WLANThermo/WLANThermo_Hardware/mini v3/Readme.md

WLANThermo Mini V3 Hardware Files

License: Creative Commons - Attribution - Non-Commercial - Share Alike license
