WLANThermo/WLANThermo_Hardware/mini v2/Readme.md

An dieser Stelle findest du die Open-Source-Inhalte zum WLANThermo Mini v2.

Inhaltsverzeichnis:
- case: beinhaltet den Link zu den Druckdateien für das 3D-Druck-Gehäuse
- bom: beinhaltet die Komponentenliste mit Lieferanten-Links
- circuit: beinhaltet den Schaltplan der Platine und den Bestückungsaufdruck
- documentation: beinhaltet alle Aufbauhilfen und Prozessanleitungen
- gerber: beinhaltet die GERBER-Dateien der Platine
- picture: beinhaltet Bilder rund ums Mini und den Dokumentationen
- target: beinhaltet das Target-Projekt zur Platine

Weitere Informationen zum WLANThermo Mini v2 findest du auf der [WLANThermo-Homepage](https://wlanthermo.de/) oder im [WLANThermo-Forum](https://forum.wlanthermo.de/).
