WLANThermo/WLANThermo_Hardware/mini v2/gerber/Readme.md

Hinweise zur Platinenherstellung:

- Layer: 2
- PCB Thickness: 1.0 mm
- Copper Weight: 1oz 35um
- PCB Color: black
- Surface Finish: Hasl (lead free)
