WLANThermo/WLANThermo_Hardware/mini v2/case/Readme.md

Für das WLANThermo Mini v2 findest du das aktuelle 3D-Druck-Gehäuse auf thingiverse. Siehe [hier](https://www.thingiverse.com/thing:2134403). Du kannst dir ein Gehäuse entweder anhand der hier hinterlegten STL-Dateien selbst drucken oder die STL-Dateien an einen Druckdienst weitergeben und es dort fertigen lassen. Eine Anleitung, wie das geht, findest du [hier](https://github.com/WLANThermo/WLANThermo_Hardware/blob/master/mini%20v1/documentation/Geh%C3%A4usebestellung_3DHubs.pdf). Als dritte Option besteht auch noch die Möglichkeit ein Gehäuse im WLANThermo-Shop zu bestellen.

Hinweis: Die in der BOM angegebenen Schrauben gelten für die hier verlinkte Gehäusevariante. Andere Gehäusevarianten benötigen u. U. andere Schrauben.
