WLANThermo/WLANThermo_Hardware/mini v1/gerber/Readme.md

Für die Herstellung der Platine werden die hier abgelegten GERBER-Dateien benötigt. Die Platinen können z. B. hier gefertigt werden:
http://www.seeedstudio.com/service/index.php?r=pcb

Dafür die "GERBER Mini v1 Funk.zip" Datei auf der Homepage des Herstellers hochladen und folgende Fertigungseinstellungen wählen:

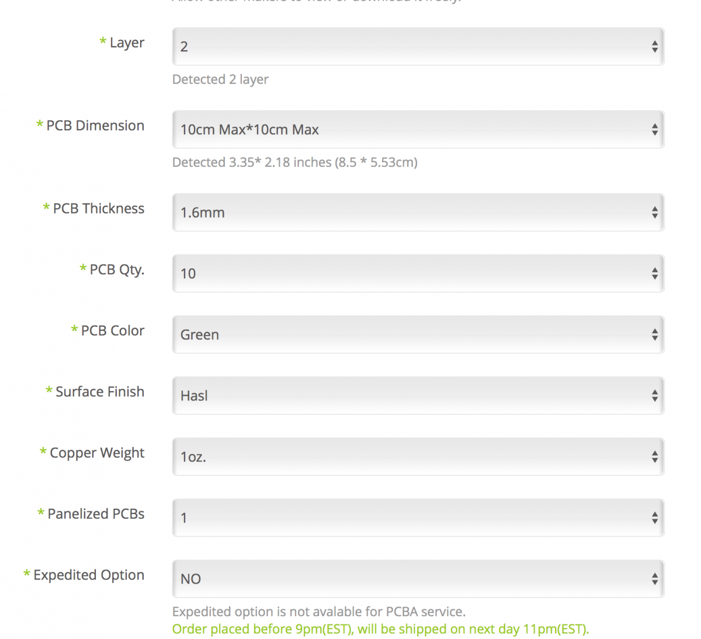
[picture p1: mini v1/picture/Platinenbestellung.png]
Platinenbestellung


Wer sich selbst keine Platine herstellen lassen will, der kann im [WLANThermo-Forum](https://forum.wlanthermo.de/) nach einer Sammelbestellung Ausschau halten oder eine Platine im [WLANThermo-Shop] bestellen.
