WLANThermo/WLANThermo_Hardware/mini v1/case/maloriak/v2/liesmich.txt

===========================================================================
             Gehäuse für das WLAN-Thermometer "Mini"
===========================================================================

// Für FDM-Drucker angepasste Version des 
// originalen Gehäuses mit runden Ecken von Sisi
//
// Kontakt: Maloriak@Grillsportverein bzw. maloriak@gmail.com
//
// Version 2.2 v. 13.2.2016
//
// Als Unterschied zur originalen Version habe ich den Deckel plan
// gemacht, damit er auf dem Drucktisch zu liegen kommmt und die 
// kleinen Gnubbel am Boden entfernt. Die Außenmasse von Deckel und Boden 
// sind daher gleich geblieben, ebenso die Innenmasse.
//
// Die Position der Anschlußlöcher im Deckel waren wohl etwas knapp,
// daher habe ich sie 0,7mm weiter Richtung Boden verschoben.
//
// Der Deckel und der Boden sind beide in dieser SCAD-Datei enthalten, sodass das einwandfreie
// Zusammenpassen der Teile anhand von Referenzpunkten sichergestellt ist.
//
// Ob der Boden oder der Deckel erzeugt wird und welche Anschlußlöcher erzeugt werden und
// ob Vorkehrungen gegen das Warpen generiert wird, lässt sich mittels Parameter einstellen.

// Dateien habe ich alle, zum Teil mehrfach, in PLA mit den Cura-Einstellungen
// 0.2 Schichtdicke, 20% Füllgrad, 0,8mm Wandstärke, 0,4mm unten/oben
// gedruckt und getestet. Mein Cura-Profil habe ich im Verzeichnis Cura-Profil abgelegt.
// Den Deckel im Slicer natürlich um 180 Grad drehen;-)

Fotos befinden sich im Unterverzeichnis Fotos und auf
http://www.grillsportverein.de/forum/threads/wlan-thermometer-mini-gehaeuse-varianten.253520/

Hinweise und Changelog siehe WTM_MaloriakV22.scad

Was bedeuten die Dateien?
==========================

a) Quelldatei, in der die originalen STL-Dateien importiert wurden und aus der die neuen 
  STL-Dateien generiert wurden:
  SCAD/WTM_MaloriakV22.scad

b) zum Selbstdrucken z.B. auf PLA-Druckern. 
Ich habe dort *immer* Schutz gegen das Warpen, also das Hochbiegen vom 
Drucktisch benötigt. Zusätzliche Eckchen halten die Ecken am Drucktisch fest.
Der von z.B. Cura automatisch generierte Schutz hat nicht so gut funktioniert,
daher habe ich ihn direkt in das Design integriert.

Boden: 
  STL_mit_Warp/WTM_Boden_V22.stl
Deckel (eine davon):
  STL_mit_Warp/Deckel_LMR_V22.stl
  STL_mit_Warp/Deckel_LR_V22.stl
  STL_mit_Warp/Deckel_M_V22.stl
  STL_mit_Warp/Deckel_V22.stl

LMR/LR/M bedeutet: Loch mitte/links/rechts

c) zum Selbstdrucken oder Drucken lassen und falls kein Warpschutz notwendig:

Boden: 
  STL/WTM_Boden_V22.stl
Deckel (eine davon):
  STL/Deckel_LMR_V22.stl
  STL/Deckel_LR_V22.stl
  STL/Deckel_M_V22.stl
  STL/Deckel_V22.stl

Falls jemand Verbesserungen/Änderungen an der Quelldatei macht, bitte 
an mich zurückmelden, damit ich sie einbauen kann.
  
Viel Erfolg beim Nachdrucken!

  LG Maloriak
===========================================================================
