WLANThermo/WLANThermo_Hardware/mini v2/documentation/QSGMini_DE.pdf

# Quick Start Guide

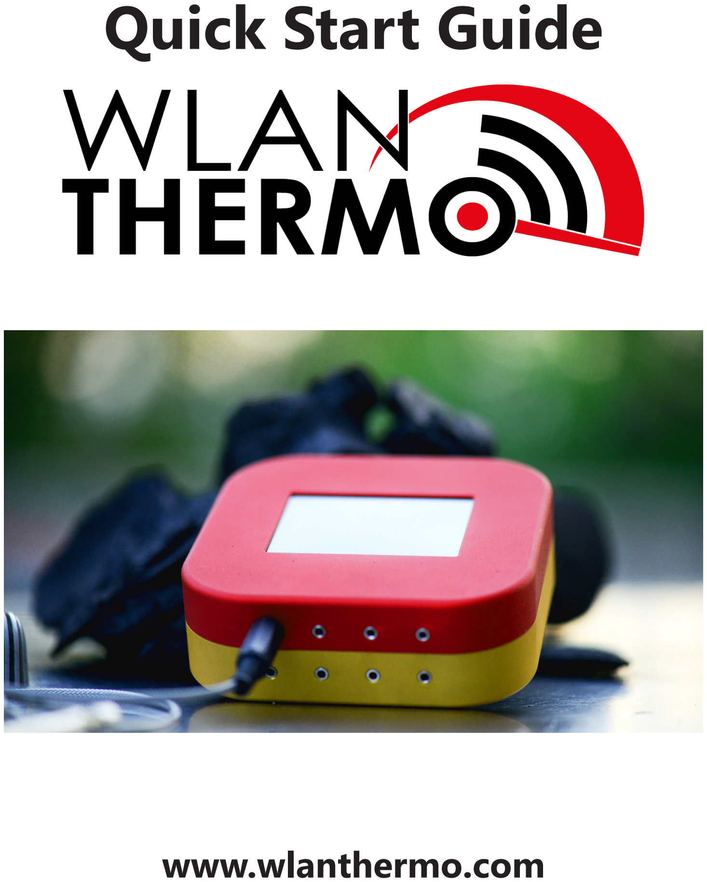
[picture p29: page 1]

## www.wlanthermo.com

2 | Inhaltsverzeichnis
3 | Hardware
3 | Vorderseite
3 | Rückseite
4 | Erste Schritte
4 | 1. Erste Inbetriebnahme
5 | 2. WLAN verbinden
6 | 3. Display Menü
7 | 4. Kanäle
9 | 5. Pitmaster
13 | GUI
16 | Credits

# Inhaltsverzeichniss:

## Hardware:

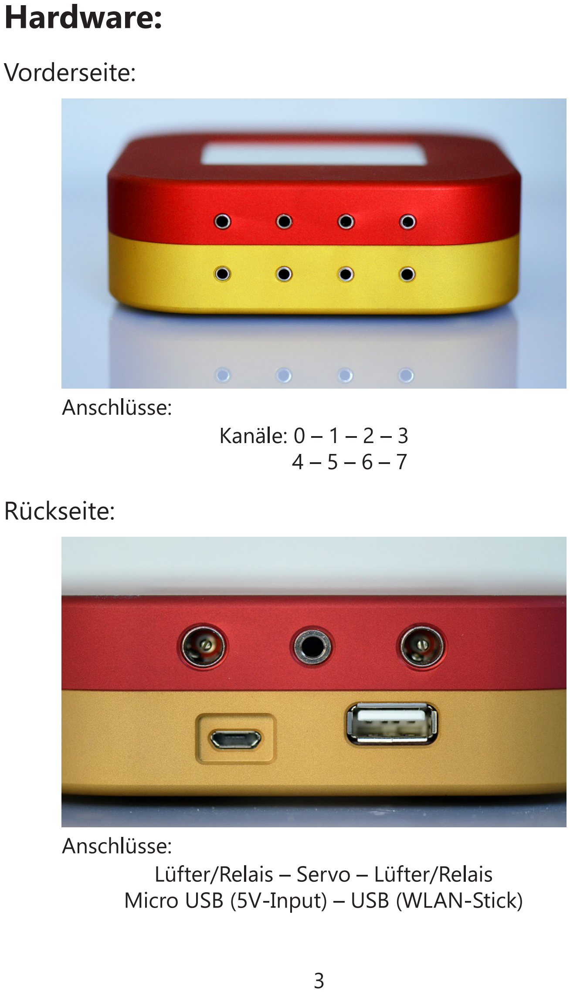
[picture p30: page 3]

Vorderseite:

Rückseite:

Kanäle: 0 – 1 – 2 – 3
4 – 5 – 6 – 7

Lüfter/Relais – Servo – Lüfter/Relais Micro USB (5V-Input) – USB (WLAN-Stick)

Anschlüsse:

Anschlüsse:

## Erste Schritte: 1. Erste Inbetriebnahme

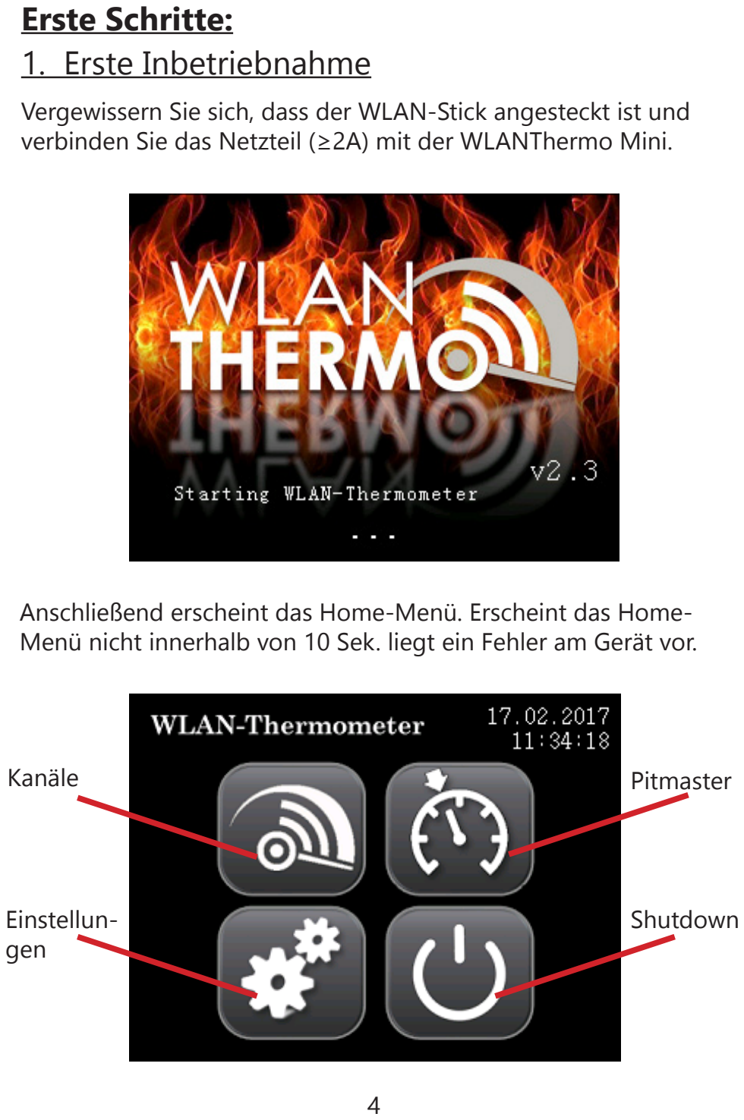
[picture p31: page 4]

Einstellungen

Kanäle | Pitmaster

Shutdown

Vergewissern Sie sich, dass der WLAN-Stick angesteckt ist und verbinden Sie das Netzteil (≥2A) mit der WLANThermo Mini.

Anschließend erscheint das Home-Menü. Erscheint das Home-Menü nicht innerhalb von 10 Sek. liegt ein Fehler am Gerät vor.

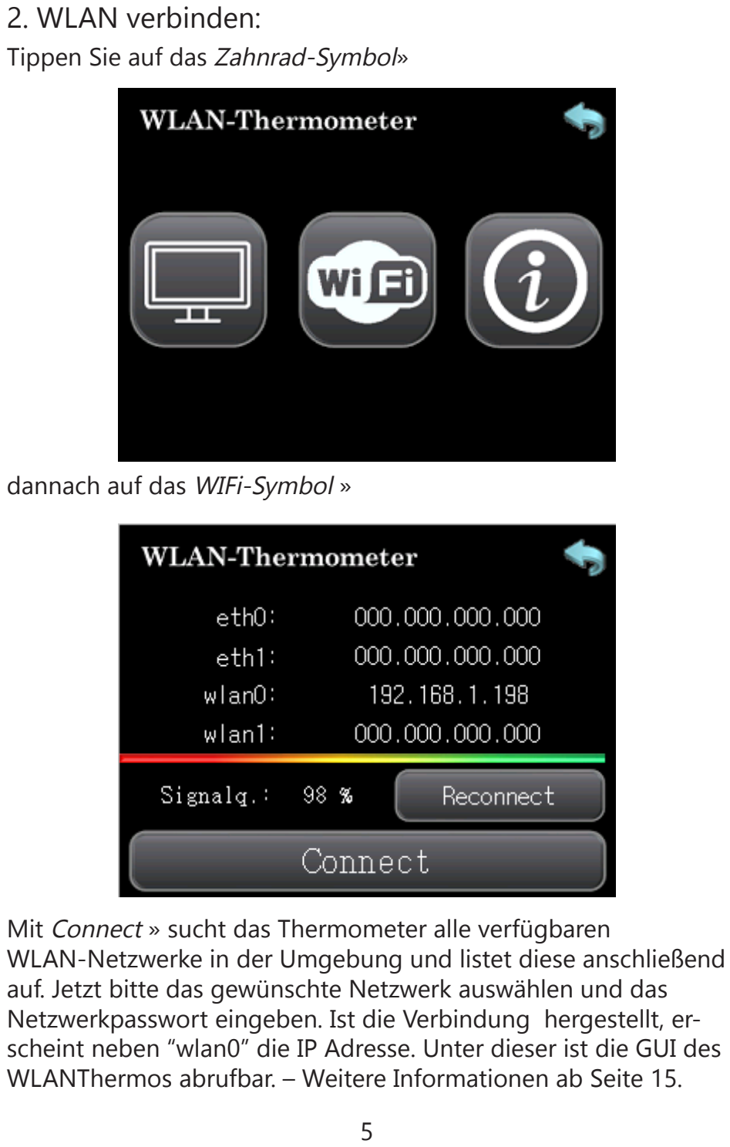
[picture p32: page 5]

dannach auf das WIFi-Symbol »

Mit Connect » sucht das Thermometer alle verfügbaren WLAN-Netzwerke in der Umgebung und listet diese anschließend auf. Jetzt bitte das gewünschte Netzwerk auswählen und das Netzwerkpasswort eingeben. Ist die Verbindung hergestellt, erscheint neben “wlan0” die IP Adresse. Unter dieser ist die GUI des WLANThermos abrufbar. – Weitere Informationen ab Seite 15.

2. WLAN verbinden:
Tippen Sie auf das Zahnrad-Symbol»

3. Display Menü:

Unter Zahnrad-Symbol» Display-Symbol » kann man die Helligkeit des Displays einstellen und festlegen, ob und wann es sich abschalten soll.

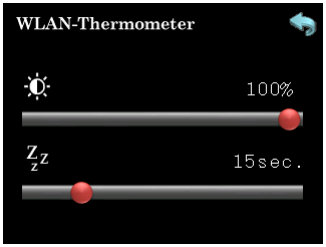
[picture p33: figure]

Es schaltet sich NUR das Display ab, das Thermometer bleibt eingeschaltet! Durch Antippen des Displays schaltet es sich jederzeit wieder ein.

Mit dem Pfeil kommt man immer zum vorherigen Menü »

4. Kanäle:
Unter dem Thermometer-Symbol » werden alle 8 Kanäle (nummeriert von 0-7) und, wenn aktiv, die Werte des Pitmaster angezeigt. Die Anzeigereihenfolge des Pitmasters ist: Ist-/Soll-Temperatur und aktuelle Aktorleistung zwischen 0 % und 100 %

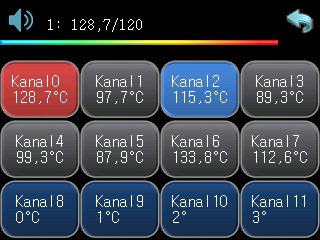
[picture p34: figure]

Wird ein Alarm ausgelöst, ertönt ein Signal – der Kanal bei dem die Temperatur überschreiten wird rot und beim unterschreiten blau eingefärbt. Links oben erscheint ein Lautsprecher-Symbol »

Ein antippen des Lautsprecher-Symbols » quittiert den Alarm, zudem wird es durchgestrichen dargestellt. Wird dannach erneut ein Alarm ausgelöst ertönt abermals ein Signalton. Sind alle Kanäle wieder im eingestellten Temperaturbereich stellt sich der Alarm von selbst wieder scharf.

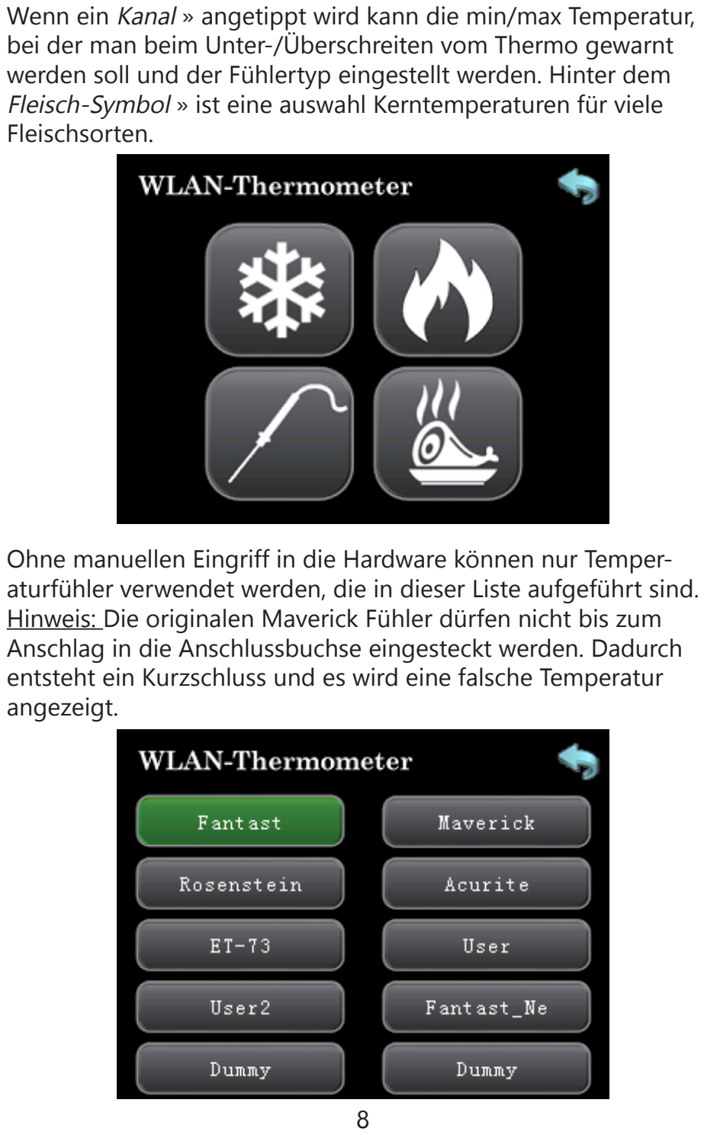
[picture p35: page 8]

Wenn ein Kanal » angetippt wird kann die min/max Temperatur, bei der man beim Unter-/Überschreiten vom Thermo gewarnt werden soll und der Fühlertyp eingestellt werden. Hinter dem Fleisch-Symbol » ist eine auswahl Kerntemperaturen für viele Fleischsorten.

Ohne manuellen Eingriff in die Hardware können nur Temperaturfühler verwendet werden, die in dieser Liste aufgeführt sind. Hinweis: Die originalen Maverick Fühler dürfen nicht bis zum Anschlag in die Anschlussbuchse eingesteckt werden. Dadurch entsteht ein Kurzschluss und es wird eine falsche Temperatur angezeigt.

Der Pitmaster kann unter dem Pitmaster-Symbol » aktiviert und eingestellt werden

5. Pitmaster:

Mit dem Pitmaster ist es möglich die Temperatur eines Grills oder Smokers mit einem Lüfter oder Servo zu steuern. Es kann auch mittels Gastronormschale, Heizmatte und SSR (SolideStateRelay) ein DIY Sous-Vide Garer gebaut weden.
Weitere Infos dazu unter: www.wlanthermo.com

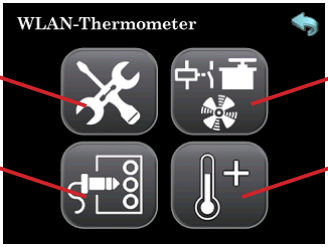
[picture p36: figure]

Kanal

Pitmaster
Steuerung

Servo/
Lüfter/Relais

Soll
Temperatur

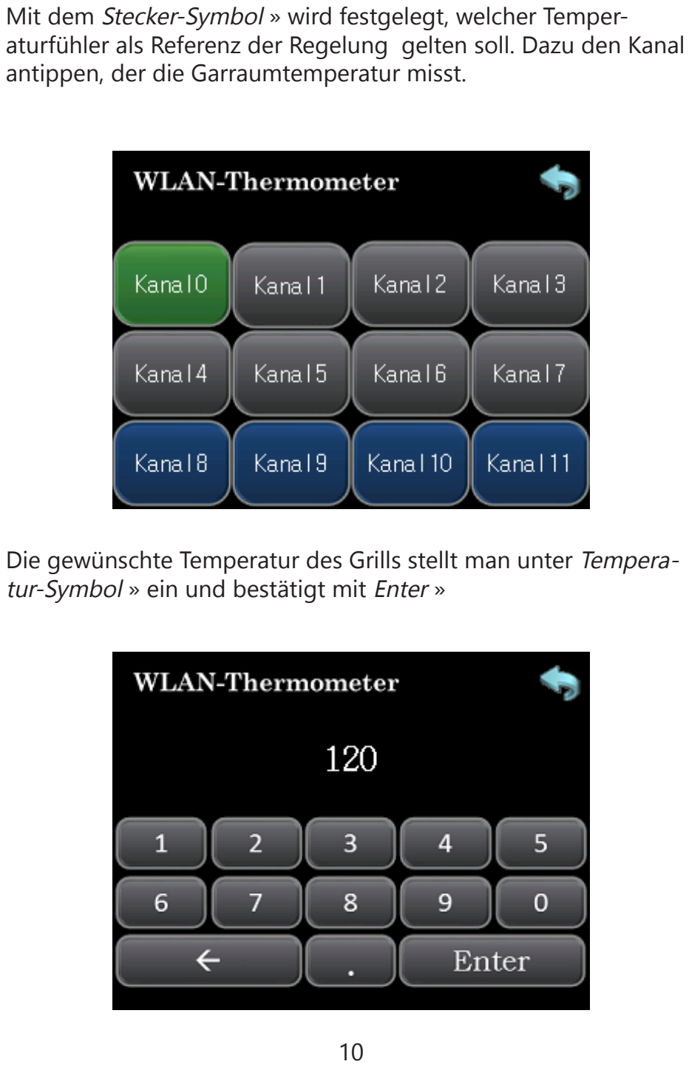
[picture p37: page 10]

Die gewünschte Temperatur des Grills stellt man unter Temperatur-Symbol » ein und bestätigt mit Enter »

Mit dem Stecker-Symbol » wird festgelegt, welcher Temperaturfühler als Referenz der Regelung gelten soll. Dazu den Kanal antippen, der die Garraumtemperatur misst.

Um das Gerät auszuwählen mit dem der Grill gesteuert werden soll auf das Symbol » mit Lüfter/Relais/Servo drücken.

Diese Geräte stehen zur Auswahl:
Servo - Lüfter - PWM Lüfter Relais - SSR (Solid State Relais)

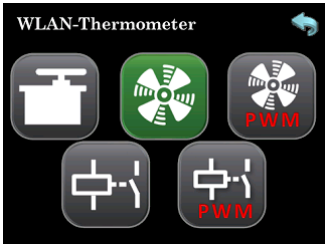
[picture p38: figure]

Mehr Information zu den verwendbaren Geräten und deren Verwendung unter: www.wlanthermo.com

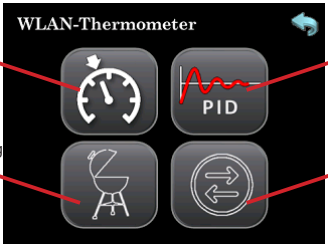
[picture p39: figure]

- Pitmaster on/off: ein/aus-schalten des Pitmasters.
- PID on/off: schaltet zwischen PID Regelung und Regelkurve um.
- Deckelüberwachung: lässt das Thermometer erkennen, dass der Deckel geöffnet ist und unterbricht den Pitmaster bis der Deckel wieder geschlossen ist.
- Ansteuerung umkehren: ändert beim Servo die Laufrichtung, beim Lüfter wird bei 0% Reglerausgangswert Vollgas gegeben, bei 100% bleibt er stehen und bei einem noramalen Relais kann damit NO oder NC (NO=Relais ist ohne angelegtem Strom Offen, NC=geschlossen) gedreht werden.

Pitmaster
on/off

Deckelüberwachung

PID on/off

Ansteuerung
umkehren

## GUI (graphical user interface):

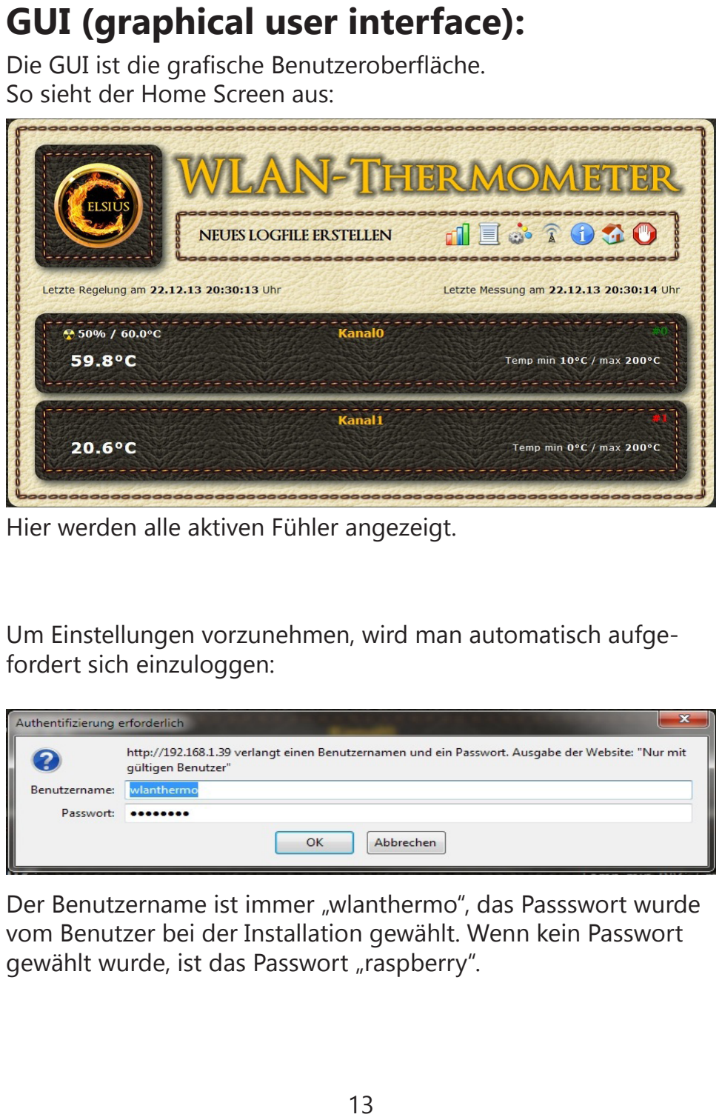
[picture p40: page 13]

Die GUI ist die grafische Benutzeroberfläche. So sieht der Home Screen aus:

Hier werden alle aktiven Fühler angezeigt.

Um Einstellungen vorzunehmen, wird man automatisch aufgefordert sich einzuloggen:

Der Benutzername ist immer „wlanthermo“, das Passswort wurde vom Benutzer bei der Installation gewählt. Wenn kein Passwort gewählt wurde, ist das Passwort „raspberry“.

Das ist die Menüleiste:

Sie enthält:

Speichert das bestehende Logfile und erstellt ein Neues und startet den Plot. Die Plot-Grafik wird nur dann auch gespeichert, wenn sie beim Erstellen eines neuen Loggfiles (siehe Unten) aktiv ist.

Aktiviert/Deaktiviert die Plot-Grafik.

Öffnet eine Seite mit den gespeicherten Logfiles, hier kann man diese auch herunterladen.

Öffnet die Einstellungen

Öffnet die WLAN Einstellungen

Öffnet eine Seite mit allgemeinen Informationen über das WLAN-Thermo. Auch Updates können hier installiert werden.

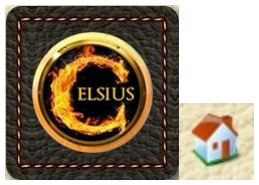
[picture p41: figure]

Mit beiden Symbolen gelangt man zurück zum Home Screen.

Hiermit ist das Herunterfahren und Neustarten möglich.
Es wird empfohlen, das WLANThermo immer herunterzufahren und nicht einfach den Stecker zu ziehen!!

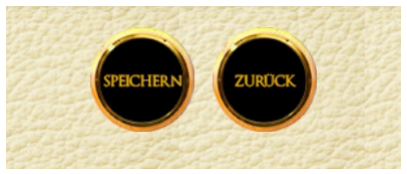
[picture p42: figure]

Mit “Speichern” werden die Änderungen gesichert und man kehrt zum Home Screen zurück. Mit “Zurück” wechselt man ohne zu speichern zum Home Screen.

Concept, Hardware & Backend © 2013-2016 Armin Thinnes
Web-Frontend © 2013-2016
Florian Riedl
Watchdog, Pitmaster © 2013-2015 Joe16
Display, Pitmaster © 2015-2016 Bjoern
Grafik © 2013
Michael Spanel
PCB Design & Layout © 2013-2015 Grillprophet
Display Design & PCB Mini © 2015-2016 Alexander Schäfer
Quick Start Guide © 2016
Michael Puswald

## www.wlanthermo.com
