WLANThermo/WLANThermo_Hardware/mini v1/documentation/Gehäusebestellung_3DHubs.pdf

# Gehäuse auf 3DHubs bestellen

Version 1.0

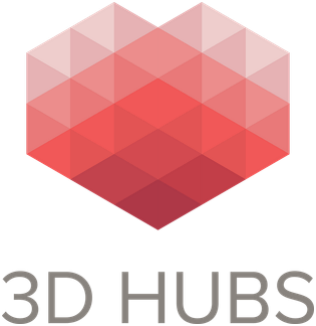
[picture p53: figure]

## Inhaltsverzeichnis

## 1 Was ist 3DHubs.com?

Die in Amsterdam ansässige Firma 3DHubs.com bietet eine Internetplattform für die Vermittlung von 3D-Druckerkapazitäten an.
Anbieten dürfen dort registrierte Privatpersonen und auch kommerzielle Händler.
Für die Vermittlung der Druckaufträge verlangt 3D-Hubs eine Provisionsgebühr von den Anbietern. Als Gegenleistung bekommen beide Seiten, Käufer und Anbieter, einen gut funktionierenden Service, Bewertungs- und Bezahlsystem. Zwischen Auftragsvergabe und Auslieferung wird das Geld bei 3D-Hubs geparkt, so haben beide Seiten eine Sicherheit.

Für die Qualität der Drucke ist der Hub verantwortlich. Geschäfte werden also direkt zwischen Käufer und Anbieter abgewickelt. 3D-Hubs erwartet von den Anbietern gewisse Mindeststandards, kontrolliert diese aber im Normalfall nicht.

## 2 Bestellvorgang Schritt für Schritt

## 2.1. Dateien hochladen

Ziehen Sie die Datei direkt in das Fenster oder suchen Sie die Datei auf Ihrem PC über "Browse for a file". Es können mehrere STL Dateien hochgeladen werden.
Je nach Größe dauert es jetzt nur ein paar Sekunden bis zu ein paar Minuten bis das Objekt hochgeladen wurde. Rechts neben dem Objekt kann die Menge angepasst werden

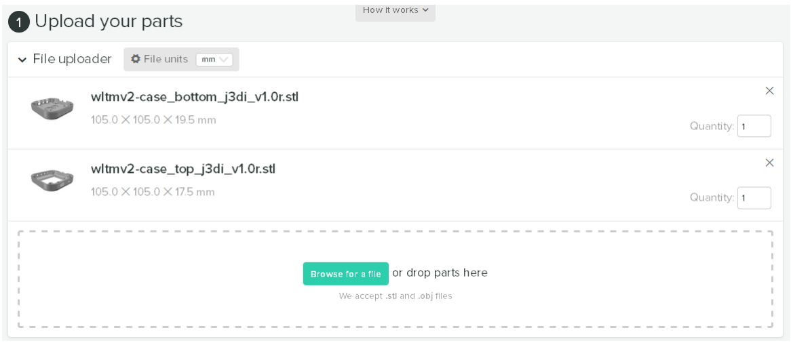
[picture p54: figure]

## 2.2. Material auswählen

Weiter geht es mit der Materialauswahl. Sie haben die Wahl zwischen vielen verschiedenen Materialen die alle für verschiedene Einsatzzwecke gedacht sind. Prototyping Plastics ist für das Gehäuse aber in nahezu allen Fällen ausreichend.

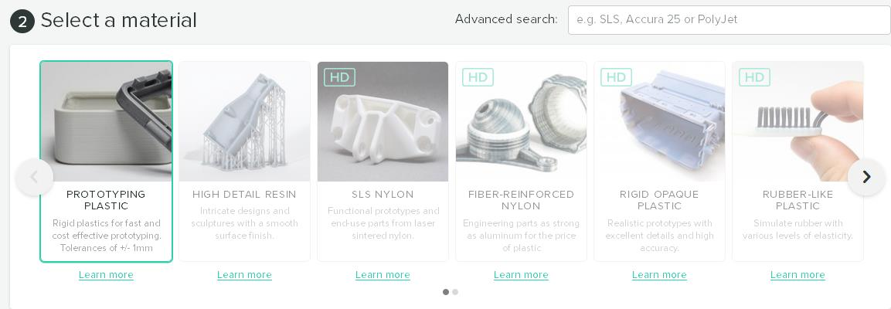
[picture p55: figure]

## 2.3. Eigenen Standort angeben

Rechts im Bild geben Sie Ihre PLZ ein. Evtl. ist ein Anbieter so nah das die Sachen sogar persönlich abgeholt werden können.

## 2.4. Anbieter aussuchen

Die Suchergebnisse listen nun etliche Hubs auf. Dort suchen Sie jemanden aus der schon einige Aufträge abgewickelt hat (Bewertungen lesen) und nach Möglichkeit PETG anbietet (wird auch oft als Colorfabb XT/NGEN dort bezeichnet). Nehmen Sie sich die Zeit und schauen Sie sich einige Hubs an. Es wird Ihnen direkt die Entfernung zum Anbieter, ungefährer Preis, ungefährer Liefertermin und seine Druck Musterteile angezeigt.

Es gibt auch die Möglichkeit den Hub aufzurufen und "contact this hub" anzuklicken.
So kann man vorher mit dem Hub in Verbindung treten ohne direkt einen Auftrag zu vergeben. Fragen, Sonderpreise, etc. lassen sich so vorher gut abklären.
Es besteht auch die Möglichkeit dem Hub auch nur den Link zu dem Teil auf Thingiverse schicken. Er kann sich dort die Daten (und Druckparameter) anschauen und Ihnen ein Angebot machen

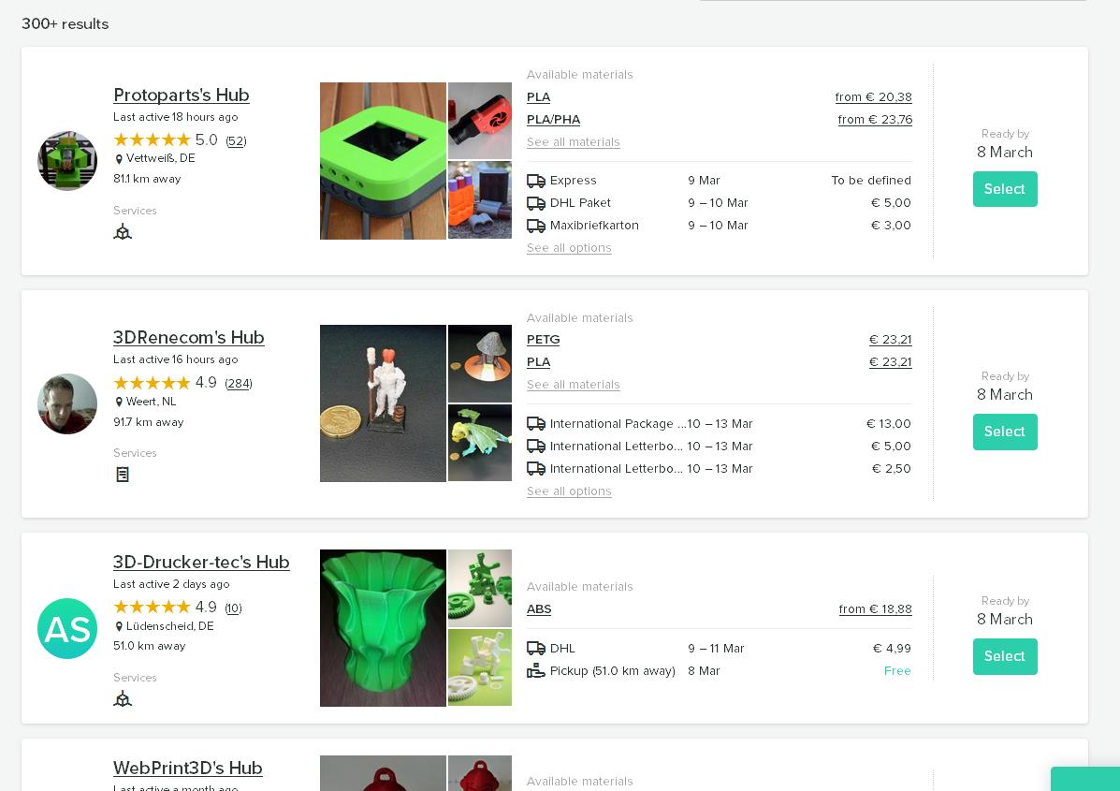
[picture p56: figure]

## 2.5. Anbieter kontaktieren

Haben Sie sich für einen Hub entschieden so kann man über Select die Anfrage starten. Man wähl erst das Material aus (PETG ist hier zu empfehlen) das man möchte. Wer nach Einsparungsmöglichkeiten sucht kann auch PLA auswählen. PLA ist allerdings etwas spröder und hat eine geringere Temperaturstabilität.

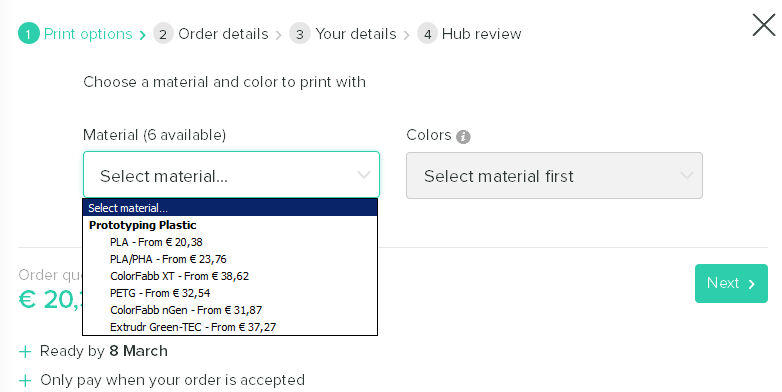
[picture p57: figure]

Anschließend wird die Auflösung und Farbe ausgewählt.
Auflösung zwischen 150 und 200 Microns (gutes Preis/Leistungsverhältnis).
Eine feinere Auflösung treibt im Regelfall nur den Preis in die Höhe ohne eine nennenswerte Qualitätsverbesserung bei den Gehäusen zu erzielen.
Wenn die Wunschfarbe nicht gelistet ist kann das unter Umständen später noch mit dem Hub geklärt werden. Am besten hierfür vorher mit dem Wunsch-Hub Kontakt aufnehmen.

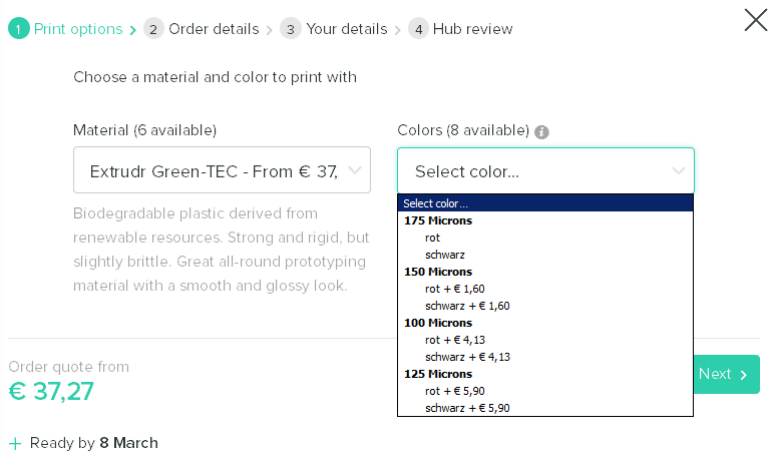
[picture p58: figure]

Anschließend wird die Versandart angegeben.

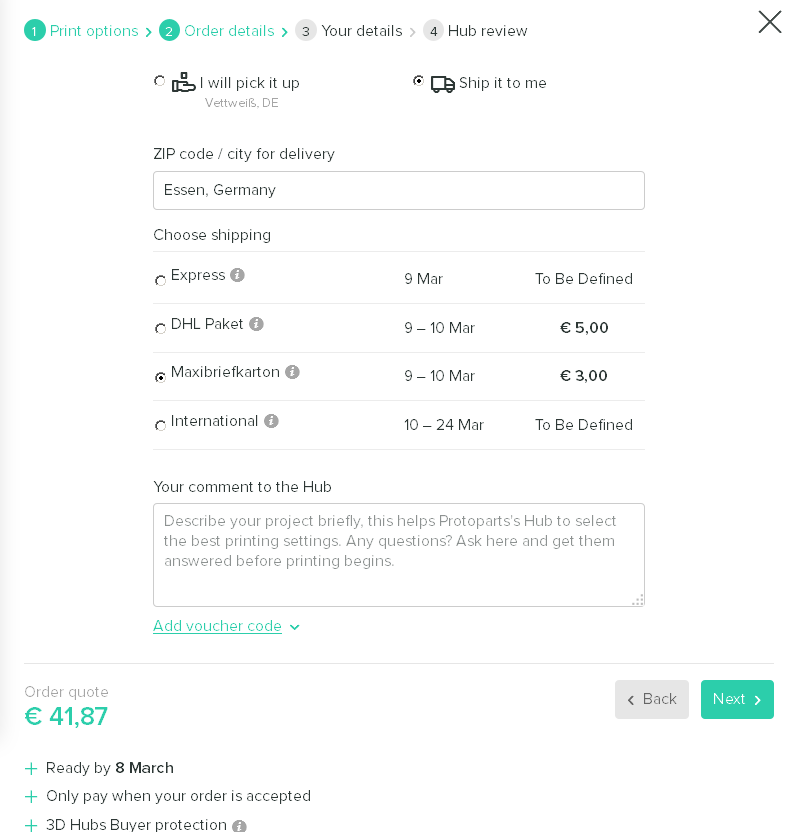
[picture p59: figure]

Kontaktformular ausfühlen und abschicken.
Der Hub wird Ihre Anfrage bearbeiten und sich anschließend mit Ihnen in Kontakt setzen.

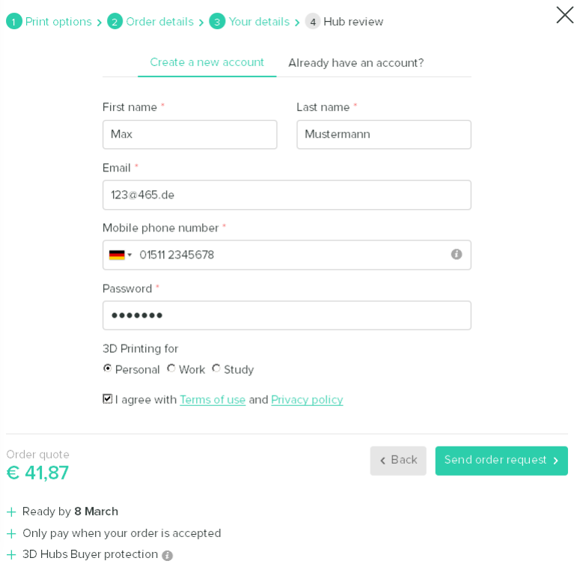
[picture p60: figure]
