WLANThermo/WLANThermo_Hardware/mini v3/bom/BOM-WLANThermo Mini v3.pdf

### BOM - WLANThermo Mini V3

Version: | 02/2021
By: | s.ochs | https://wlanthermo.de

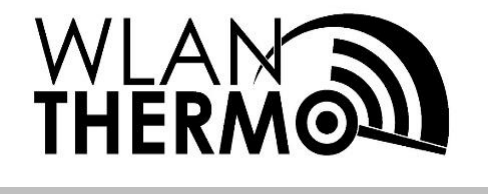
[picture p61: figure]

Kennung | Bauteilbezeichnung | Anmerkung | Größe | Menge Händler | Alternative Kit [1]

IC1 MCP73831T-2ACI/OT Battery Management SOT-23-5 1 Mouser[2] (http://www.mouser.de/ProductDetail/Microchip/MCP73831T-2ACI-OT/) reichelt (https://www.reichelt.de/battery-management-ic-li-ionen-li-polymer-sot-23-5-mcp-73831t-2aci-p217314.html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)
IC2 MCP3208-CI/SL 12-bit A/D Converter, 8-Kanal SOIC-16 1 Mouser (https://www.mouser.de/ProductDetail/Microchip-Technology/MCP3208T-CI-SL/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) IC3 LP2985IM5-3,3 Reference Voltage 3.3V SOT-23-5 1 Mouser (https://www.mouser.de/ProductDetail/Texas-Instruments/LP2985IM5-33-NOPB/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) | reichelt (https://www.reichelt.de/MCP-3208-CI-SL/3/index.html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) reichelt (https://www.reichelt.de/LP-2985-IM5-3-3/3/index.html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)

IC4 TLV61046ADBVR Switching Voltage Regulator SOT-23-6 1 Mouser (https://www.mouser.de/ProductDetail/595-TLV61046ADBVR) ---IC5 TLV271CDBVR Rail-to-Rail Operational Amplifier SOT-23-5 1 Mouser (https://www.mouser.de/ProductDetail/Texas-Instruments/TLV271CDBVR?qs=Fg5TsMy7H4shdkD8qrn20w%3D%3D) ---IC6 MAX31855KASA Thermocouple to Digital Converter SOIC-8 1 Mouser (https://www.mouser.de/ProductDetail/Maxim-Integrated/MAX31855KASA%2b/?qs=ffX8NcjNb2QF5YDuL5Qj5g%3D%3D) ---

C1 | GRM31CR60J107ME39L | 100uF, 6.3V, 20%, X5R | SMD 1206 | 1 Mouser (https://www.mouser.de/ProductDetail/Murata-Electronics/GRM31CR60J107ME39L) | reichelt (https://www.reichelt.de/smd-vielschichtkondensator-g1206-100-f-6-3v-x5r-g1206-100-6-p89744.html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)
C2 / C3 | GRM21BR61E226ME44L | 22uF, 25V, 20% | SMD 0805 | 2 Mouser (https://www.mouser.de/ProductDetail/Murata-Electronics/GRM21BR61E226ME44L) | ---
C4 - C7 | CL21B106KPQNNNE | 10uF, 10V, 10%, X7R | SMD 0805 | 4 Mouser (https://www.mouser.de/ProductDetail/Samsung-Electro-Mechanics/CL21B106KPQNNNE/) | reichelt (https://www.reichelt.de/smd-vielschichtkondensator-g0805-10-f-16v-x5r-g0805-10-16-p89734.html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)
C8 / C9 | CC0805KRX7R9BB103 | 0.01uF, 50V, 10%, X7R | SMD 0805 | 2 Mouser (https://www.mouser.de/ProductDetail/Yageo/CC0805KRX7R9BB103/) | reichelt (https://www.reichelt.de/smd-vielschicht-keramikkondensator-10n-10--x7r-g0805-10n-p22877.html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)
C10 - C20 | CC0805KRX7R9BB104 | 0.1uF, 50V, 10% | SMD 0805 | 11 Mouser (https://www.mouser.de/ProductDetail/Yageo/CC0805KRX7R9BB104/?qs=vTakOoo5QyLx0lXWgVtRhQ%3D%3D) | reichelt (https://www.reichelt.de/smd-vielschicht-keramikkondensator-100n-10--x7r-g0805-100n-p31879.html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)
R1 | CRCW08052K00FKEAC | 2K, 1%, 0.125W ±100ppm/℃ | SMD 0805 | 1 Mouser (https://www.mouser.de/ProductDetail/Vishay-Dale/CRCW08052K00FKEAC/?qs=E3Y5ESvWgWP6floxGsbShA%3D%3D) | reichelt (https://www.reichelt.de/smd-widerstand-0805-2-0-kohm-125-mw-1--rnd-0805-1-2-0k-p183235.html?trstct=pol_0&nbc=1)
R2 | CRCW06034K99FKEAC | 4.99K, 1%, 0.125W ±100ppm/℃ | SMD 0603 | 1 Mouser (https://www.mouser.de/ProductDetail/Vishay/CRCW06034K99FKEAC) | reichelt (https://www.reichelt.de/smd-widerstand-0603-4-99-kohm-100-mw-1--rnd-0603-1-4-99k-p213098.html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)
R3 | CRCW08053K48FKEAC | 3.48K, 1%, 0.125W ±100ppm/℃ | SMD 0805 | 1 Mouser (https://www.mouser.de/ProductDetail/Vishay-Dale/CRCW08053K48FKEAC/?qs=E3Y5ESvWgWOShIrVgwq%252B4g%3D%3D) | reichelt (https://www.reichelt.de/smd-widerstand-0805-3-6-kohm-125-mw-1--rnd-0805-1-3-6k-p183241.html?trstct=pol_0&nbc=1)
R4 | CRCW080522K0FKEAC | 22K, 1%, 0.125W ±100ppm/℃ | SMD 0805 | 1 Mouser (https://www.mouser.de/ProductDetail/Vishay-Dale/CRCW080522K0FKEAC/?qs=E3Y5ESvWgWM%252BLh7gNR1oHw%3D%3D) | reichelt (https://www.reichelt.de/smd-widerstand-0805-22-kohm-125-mw-1--smd-0805-22-0k-p32902.html?trstct=pol_3&nbc=1)
R5 | CRCW0805330KFKEA | 330K, 1%, 0.125W ±100ppm/℃ | SMD 0805 | 1 Mouser (https://www.mouser.de/ProductDetail/Vishay-Dale/CRCW0805330KFKEA/?qs=TrAHXYCGmqzWYzXuWlB%252BLQ%3D%3D) | reichelt (https://www.reichelt.de/smd-widerstand-0805-330-kohm-125-mw-1--smd-0805-330k-p32916.html?trstct=pol_4&nbc=1)
R6 | CRCW0805100KFKEAC | 100K, 1%, 0.125W ±100ppm/℃ | SMD 0805 | 1 Mouser (https://www.mouser.de/ProductDetail/Vishay-Dale/CRCW0805100KFKEAC/?qs=E3Y5ESvWgWORJvbAiaO1ug%3D%3D) | reichelt (https://www.reichelt.de/smd-widerstand-0805-100-kohm-125-mw-1--smd-0805-100k-p32910.html?trstct=pol_2&nbc=1)
R7 - R12 | CRCW080510K0FKEAC | 10K, 1%, 0.125W ±100ppm/℃ | SMD 0805 | 6 Mouser (https://www.mouser.de/ProductDetail/Vishay-Dale/CRCW080510K0FKEAC/?qs=E3Y5ESvWgWORadmUijPtxQ%3D%3D) | reichelt (https://www.reichelt.de/smd-widerstand-0805-10-kohm-125-mw-1--smd-0805-10-0k-p32898.html?trstct=pol_2&nbc=1)
R13 - R22 | CRCW08051K00FKEAC | 1K, 1%, 0.125W ±100ppm/℃ | SMD 0805 | 10 Mouser (https://www.mouser.de/ProductDetail/Vishay-Dale/CRCW08051K00FKEAC/?qs=CZ6xfwOSLTXmQIgaYvN%2FBA%3D%3D) | reichelt (https://www.reichelt.de/smd-widerstand-0805-1-0-kohm-125-mw-1--smd-0805-1-00k-p32886.html?trstct=pol_4&nbc=1)
R23 - R31 | ERA-6AEB473V | 47K, 0,1% | SMD 0805 | 9 Mouser (https://www.mouser.de/ProductDetail/Panasonic/ERA-6AEB473V/) | reichelt (https://www.reichelt.de/smd-widerstand-0805-47-kohm-125-mw-0-1--spr-0805-47-0k-p123351.html?trstct=pol_4&nbc=1)
F1 | 0ZCJ0150FF2C | Re. Fuse, IH 1.5A, IT 3.0A, 6V | SMD 1206 | 1 Mouser (http://www.mouser.de/ProductDetail/Bel-Fuse/0ZCJ0150FF2C/) | ---
F2 | 0ZCJ0050AF2E | Re. Fuse, IH 0.5A, IT 1.0A, 24V | SMD 1206 | 1 Mouser (http://www.mouser.de/ProductDetail/Bel-Fuse/0ZCJ0050AF2E/) | --- | Mouser (https://www.mouser.de/ProductDetail/Bussmann-Eaton/PTS120615V050/?qs=QmibqUXyDhQpLmnP4WG6Mg%3D%3D)
T1 - T2 | IRLML6402TR | P-MOSFET | SOT-23-3 | 2 Mouser (https://www.mouser.de/ProductDetail/?qs=9%252BKlkBgLFf0HuZuONx2Ewg%3D%3D) | reichelt (https://www.reichelt.de/mosfet-p-ch-20v-3-7a-1-3w-sot-23-irlml-6402-p108743.html?search=IRLML)

T3 | BSS138 SMD | MOSFET N-CH LOGIC | SOT-23-3 | 1 Mouser (http://www.mouser.de/ProductDetail/Fairchild-Semiconductor/BSS138/?qs=sGAEpiMZZMvlOED0T0kTWl5MKyjMqq%2fg) | reichelt (https://www.reichelt.de/mosfet-n-ch-50v-0-22a-0-36w-sot-23-bss-138-smd-p41437.html?search=BSS138)
T4 | 2SC3303 / NSS1C301 | NPN | TO-252 | 1 Mouser (https://www.mouser.de/ProductDetail/?qs=abmNkq9no6DYBsh12uOm8A%3D%3D) | reichelt (https://www.reichelt.de/hf-bipolartransistor-npn-100v-5a-20w-d-pak-sc-3303-p16702.html?trstct=pos_0&nbc=1)
D1 | APL3015QBC/D-F01 | SMD LED BLUE | SMD 1206 | 1 Mouser (https://www.mouser.de/ProductDetail/Kingbright/APL3015QBC-D-F01/?qs=f499HRGa1RnunsK7bJ1bZQ%3D%3D) | reichelt (https://www.reichelt.de/led-smd-1206-blau-150-mcd-rnd-135-00186-p263782.html?&trstct=pos_5&nbc=1)
D2 | APTR3216SURCK | SMD LED RED | SMD 1206 | 1 Mouser (http://www.mouser.de/ProductDetail/Kingbright/APTR3216SURCK/?qs=sGAEpiMZZMseGfSY3csMkeytxqHAv00AD1bkbISckRo%3d) | reichelt (https://www.reichelt.de/led-smd-1206-rot-115-mcd-rnd-135-00188-p263784.html?&trstct=pos_6&nbc=1)
D3 | MBRA340T3G | Schottky Diode, 3A, 40V | SOD-128 | 1 Mouser (https://www.mouser.de/ProductDetail/ON-Semiconductor/MBRA340T3G/) | reichelt (https://www.reichelt.de/MR-MURS-P600-RGP-Dioden/MBRA-340T3G-ONS/3/index.html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) Mouser (https://www.mouser.de/ProductDetail/STMicroelectronics/STPS2L30AFN/?qs=Cb2nCFKsA8rIJ5y5S0cAww%3D%3D)
D4 | PMEG4030ER/8X | Schottky Rectifiers, If 3A | SOD-123-2 | 1 Mouser (http://www.mouser.de/Search/ProductDetail.aspx) | ---
S1 | EG1247 / SK12D07VG4 | Schiebeschalter | | 1 Mouser (http://www.mouser.de/ProductDetail/E-Switch/EG1247/) | ---
L1 | SRN6045TA-220M | 22uH, 2.3A | SMD 6x6x4.2 | 1 Mouser (https://www.mouser.de/ProductDetail/652-SRN6045TA-220M) | reichelt (https://www.reichelt.de/chip-induktivitaet-242418fps-22-h-l-242418fps-22--p138706.html?trstct=pol_0&nbc=1) Mouser (https://www.mouser.de/ProductDetail/tdk/vls6045af-220m/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)
K1 | UJC-HP-3-SMT-TR | USB-C Connector | SMD 6 PIN | 1 Mouser (https://www.mouser.de/ProductDetail/CUI-Devices/UJC-HP-3-SMT-TR) | ---
K2 | JST PH2P ST / B2B-PH-K-S | Battery Connector | RM 2.0 | 1 Mouser (https://www.mouser.de/ProductDetail/TE-Connectivity/440054-2/?qs=JFPmFzpscO4RQaczYEA68w%3D%3D) | reichelt (https://www.reichelt.de/jst-stiftleiste-gerade-1x2-polig-ph-jst-ph2p-st-p185049.html?trstct=pos_0&nbc=1)
K3 | M20-7812045 | Socket Header 2X20, SMD | RM 2.54 | 1 Mouser (https://www.mouser.de/ProductDetail/harwin/m20-7812045/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) | ---
K4 - K9 | SJ-2523-SMT-TR | 2.5 mm Klinkenbuchse | 4 Pol | 6 Mouser (http://www.mouser.de/ProductDetail/CUI/SJ-2523-SMT-TR/?qs=WyjlAZoYn50TRxpi%2fhdHvw%3d%3d) | ---
K10 | PCC-SMP-K | Typ K Thermocouple Terminal | | 1 Mouser (https://www.mouser.de/ProductDetail/SparkFun/PRT-13612?qs=WyAARYrbSnbvS1kDzRVYBg%3D%3D) | ---
K11 | DC031A / PJ-035-SMT-TR | DAC Connector, PJ-035 = 3 Pol-Variante | 1 Mouser[3] (https://www.mouser.de/ProductDetail/CUI/PJ-035-SMT-TR?qs=WyjlAZoYn539pHvAigRXsg%3D%3D) --- | ALI (https://de.aliexpress.com/item/10PCS-LOT-DC031A-3-5-1-0mm-SMD-3-5MM-DC-Jacks-Ports-Connectors-for-Tablet/32733220562.html) | x
K11* | 171-PA35135-1-E / PP-018 | 3.5x 1.3 mm Stecker, PP-018 = 3 Pol | 1 Mouser[3] (https://www.mouser.de/ProductDetail/?qs=WyjlAZoYn51zMCKEFPATbA%3D%3D) reichelt (https://www.reichelt.de/hohlstecker-knickschutz-aussen-3-5-mm-innen-1-3-mm-hs-13-9-p8645.html) 2-Pol (https://www.mouser.de/ProductDetail/Kobiconn/171-PA35135-1-E/) | x
K12 | MOLEX 43650-0300 | MOLEX Mirco-Fit 3 PIN | RM 3.0 | 1 Mouser (https://www.mouser.de/ProductDetail/Molex/43650-0300/) | reichelt (https://www.reichelt.de/molex-stiftleiste-micro-fit-1x3-polig-stecker-molex-436500300-p186173.html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)
K12* | MOLEX 43645-0300 | MOLEX 3 PIN Stecker (ohne Kontakte) | RM 3.0 | 1 Mouser[4] (https://www.mouser.de/ProductDetail/?qs=W6FIH8d5%2F%2F06ciSdVM35nA%3D%3D) reichelt (https://www.reichelt.de/molex-crimpgehaeuse-micro-fit-1x3-polig-buchse-molex-436450300-p185679.html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)
K12* | MOLEX 43030-0008 | MOLEX Micro-Fit Crimp-Female | | 5 Mouser (https://www.mouser.de/ProductDetail/538-43030-0038/) | reichelt (https://www.reichelt.de/molex-crimpkontakt-micro-fit-buchse-molex-430300008-p185697.html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)
K13 | BKL 10120516 | Stiftleiste, 2X20, gerade | RM 2.54 | 1 Mouser (https://www.mouser.de/ProductDetail/Wurth-Elektronik/61304021121/?qs=PhR8RmCirEYWKI5WqdDUyg%3D%3D) | reichelt (https://www.reichelt.de/stiftleiste-2x20-pol-vergoldet-2-54mm-bkl-10120516-p235663.html?trstct=pos_4&nbc=1)
B1 | Li-Ion Battery | 2600 mAh Li-Ion, Typ B600BE | 63x57x5,6 | 1 --- | reichelt (https://www.reichelt.de/smartphone-akku-fuer-samsung-geraete-li-ion-2600-mah-akku-sam-15-p137134.html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) reichelt (https://www.reichelt.de/smartphone-akku-fuer-samsung-geraete-li-ion-2600-mah-akku-13291-p224537.html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)
X1 | WT TFT Kit [5] | TFT-Modul, ESP32, nRF52840 | SMD | 1 --- | --- | WT-Shop | (x)
X2 | WT Battery Kit | Battery Connector + Protection | SMD | 1 --- | --- | WT-Shop | (x)
M1 | Magnete | Neodym Quadermagnet 40 x 5 x 2 mm | | 2 --- | --- | MTS (https://www.mtsmagnete.de/neodym-quader-magnete/quader-20mm/quadermagnet-40x5x2-mm-neodym/a-5509) | x
M2 | Schrauben | M2 x 4mm, Blechschraube | | 14 --- | --- | Ebay (https://www.ebay.de/itm/100x-Miniatur-Blechschrauben-Schraube-mini-Schrauben-Blechschraube-micro/362429856292) | x
M3 | Schrauben | M3 x 25mm Linsenkopfschraube | 4 --- | reichelt (https://www.reichelt.de/pan-head-schrauben-kreuzschlitz-pzd-m3-25mm-skl-m3x25-50-p130348.html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) Baumarkt | x
P1 | Platine | 1 mm Platinendicke | | 1 github | --- | | x
G1 | 3D-Druckteile | Gehäuse + Ecksteine | 1 thingiverse (https://www.thingiverse.com/thing:4737291) --- | (x)
G2 | Buchsen-Blenden | gelaserte Seitenblenden | 4 thingiverse (https://www.thingiverse.com/thing:4737291) --- | x

[1] Mini-Kit: Bauteile, die nicht über Mouser beziehbar sind, können auf Anfrage (s.ochs@wlanthermo.de) auch als Bauteil-Kit über das WLANThermo Team bezogen werden. (x) = optinal.
[2] Mouser-Warenkorb: https://www.mouser.com/ProjectManager/ProjectDetail.aspx?AccessID=7eb45380b5
[3] Standardmäßig wird die 2-Pol-Buchse DC031A verbaut, mit passendem 2-Pol-Stecker. Mouser führt allerdings nur die 3-Pol-Buchse PJ-035-SMT-TR, benötigt 3-Pol-Stecker PP-018. Die 2-Pol und 3-Pol Bauteile sind untereinander nicht kompatibel, es muss also auf die richtige Kombination geachtet werden.
[4] Der Molex-Stecker kommt ohne Crimp-Kontakte. Es werden entweder entsprechende Anschlusskabel mit Crimp-Kontakt benötigt oder die Kontakte selbst gecrimpt werden.
[5] Die Software ist bereits vorinstalliert und direkt betriebsbereit.
