WLANThermo/WLANThermo_Hardware/link v1/bom/BOM-WLANThermo Link V1.pdf

### BOM - WLANThermo LINK V1

Version: | 09/2020
By: | s.ochs | https://wlanthermo.de

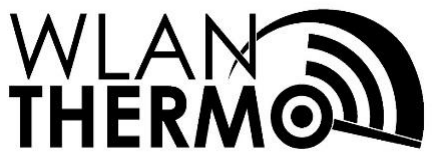
[picture p62: figure]

Kennung | Bauteilbezeichnung | Anmerkung | Größe | Menge Händler
IC1 | LM4040AIM3-2.0/NOPB | Reference Voltage 2.048V | SOT-23-3 | 1 Mouser (http://www.mouser.de/ProductDetail/Texas-Instruments/LM4040AIM3-20-NOPB/) | Mouser-WK (https://www.mouser.com/ProjectManager/ProjectDetail.aspx?AccessID=4a2930cf5e)
IC2 | MAX11613E | ADC 12bit, 4CH | QSOP-8 | 1 Mouser (https://www.mouser.de/ProductDetail/Maxim-Integrated/MAX11613EUA%2bT?qs=d3kjJb5aE2Yh9e8LMjtS%252Bw%3D%3D) | Mouser-WK
C1 | GRM31CR61A107ME05L | 100uF, 6.3V, 20%, X5R | SMD 1206 | 1 Mouser (https://www.mouser.de/ProductDetail/Murata-Electronics/GRM31CR61A107ME05L?qs=chTDxNqvsylSo93CzdbYkQ%3D%3D) | Mouser-WK
C2 - C3 | CC0603KRX7R7BB105 | 1uF, 16V, 10%, X5R/X7R | SMD 0603 | 2 Mouser (https://www.mouser.de/ProductDetail/Yageo/CC0603KRX7R7BB105?qs=sGAEpiMZZMs0AnBnWHyRQNA8i4Zgtm9tZdFjY4F8SMc%3d) | Mouser-WK
C4 | GRM188R61E225KA12D | 2.2uF, 16V, 10%, X5R/X7R | SMD 0603 | 1 Mouser (https://www.mouser.de/ProductDetail/Murata-Electronics/GRM188R61E225KA12D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) | Mouser-WK
C5 | GRM188R61C475KAAJD | 4.7uF, 16V, 10%, X7R | SMD 0603 | 1 Mouser (https://www.mouser.de/ProductDetail/Murata-Electronics/GRM188R61C475KAAJD) | Mouser-WK
C6 | GRM188R61A106KE69D | 10uF, 10V, 20%, X5R/X7R | SMD 0603 | 1 Mouser (https://www.mouser.de/ProductDetail/Murata-Electronics/GRM188R61A106KE69D) | Mouser-WK
C7 - C13 | CC0603KRX7R8BB104 | 100nF, 25V, 10%, X5R/X7R | SMD 0603 | 7 Mouser (https://www.mouser.de/ProductDetail/Yageo/CC0603KRX7R8BB104?qs=sGAEpiMZZMs0AnBnWHyRQMMzfhmH8IQXUZNM5PDuUEs%3d) | Mouser-WK
R1 | CRCW06032K32FKEAC | 2.32K, 1% | SMD 0603 | 1 Mouser (https://www.mouser.de/ProductDetail/Vishay/CRCW06032K32FKEAC) | Mouser-WK
R2 | CRCW06034K99FKEAC | 4.99K, 1% | SMD 0603 | 1 Mouser (https://www.mouser.de/ProductDetail/Vishay/CRCW06034K99FKEAC) | Mouser-WK
R3 | CRCW0603390KFKEAC | 390K, 1% | SMD 0603 | 1 Mouser (https://www.mouser.de/ProductDetail/Vishay/CRCW0603390KFKEAC) | Mouser-WK
R4 / R13 | RC0603FR-07237RL | 237R, 1% | SMD 0603 | 2 Mouser (http://www.mouser.de/ProductDetail/Yageo/RC0603FR-07237RL/?qs=sGAEpiMZZMu61qfTUdNhG5eFuApKbqVdujcdQ4I0ncs%3d) | Mouser-WK
R5 - R7 | RC0603FR-071KL | 1K, 1% | SMD 0603 | 3 Mouser (https://www.mouser.de/ProductDetail/Yageo/RC0603FR-071KL?qs=VU8sRB4EgwApHsk4rF%2F3zg%3D%3D) | Mouser-WK
R8 - R10 | RC0603DR-0747KL | 47K, 0.5% | SMD 0603 | 3 Mouser (http://www.mouser.de/ProductDetail/Yageo/RC0603DR-0747KL/) | Mouser-WK
R11 - R12 | AC0603FR-0710KL | 10K, 1% | SMD 0603 | 2 Mouser (https://www.mouser.de/ProductDetail/Yageo/AC0603FR-0710KL?qs=UoPT7wUmgYKz3zh0UDMA4Q%3D%3D) | Mouser-WK
R14 | ERJ-P06J201V | 200R, 500mW | SMD 0805 | 1 Mouser (https://www.mouser.de/ProductDetail/Panasonic/ERJ-P06J201V?qs=Zyl8A9hlmJrhf53wT1Qfrg%3D%3D) | Mouser-WK
T1 - T2 | BSS138 SMD | MOSFET N-CH LOGIC | SOT-23-3 | 2 Mouser (http://www.mouser.de/ProductDetail/Fairchild-Semiconductor/BSS138/?qs=sGAEpiMZZMvlOED0T0kTWl5MKyjMqq%2fg) | Mouser-WK
D1 | 1N5819 | Schottky Diode, If 1A, 0.5V | SOD-123 | 1 Mouser (https://www.mouser.de/ProductDetail/Diodes-Incorporated/1N5819HW-7-F?qs=NQ47qNm99eDyWTEd07miYA%3D%3D) | Mouser-WK
S1 | PTS645SM43SMTR92LFS | Tactile Switch 6x6x4,3mm | 6x6 | 1 Mouser (https://www.mouser.de/ProductDetail/CK/PTS645SM43SMTR92LFS?qs=FESYatJ8odKPktxv6ncfWg%3D%3D) | Mouser-WK
F1 | 0ZCJ0075AF2E | Re. Fuse, IH 0.75A, IT 1.5A, 16V | SMD 1206 | 1 Mouser (https://www.mouser.de/ProductDetail/Bel-Fuse/0ZCJ0075AF2E?qs=SRYZG9HaIQ0lhFCzFYQFnA%3D%3D) | Mouser-WK

enthalten in

K1 | M20-7812045 | Socket Header 2X20, SMD | RM 2.54 | 1 Mouser (https://www.mouser.de/ProductDetail/harwin/m20-7812045/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) | Mouser-WK
K2 | UJC-HP-3-SMT-TR | USB-C Connector | SMD | 1 Mouser (https://www.mouser.de/ProductDetail/CUI-Devices/UJC-HP-3-SMT-TR) | Mouser-WK
K3 - K4 | SJ-2523-SMT-TR | 2.5 mm Klinkenbuchse | | 2 Mouser (http://www.mouser.de/ProductDetail/CUI/SJ-2523-SMT-TR/?qs=WyjlAZoYn50TRxpi%2fhdHvw%3d%3d) | Mouser-WK
AL1 | SUMMER | Buzzer SMD 4kHz | 5x5x2 | 1 Mouser (https://www.mouser.de/ProductDetail/?qs=e16JbV5WBEu5VaDVzQP23Q%3d%3d) | Mouser-WK
X1 | OLED 1.3" | 128x64, I2C, blue | 30PIN | 1 | Bauteilkit (https://wlanthermo.de/threads/bezugsquellen-f%C3%BCr-den-eigenbau.1342/)
P1 | Platine | 1 mm Platinendicke | 67x40 | 1 github | Bauteilkit
P2 | ESP32-Kit* | WLANThermo ESP32 | | 1 github | Shop (https://wlanthermo.de/shop/esp32-upgrade-kit.41/)
M1 | Magnete | Neodym Quadermagnet 30 x 5 x 2 mm | | 2 | Bauteilkit
M2 | Schrauben | M2 x 4mm, Blechschraube | | 2 | Bauteilkit
M3 | Schrauben | M2 x 16mm, Kreuzsenkkopf, schwarz | | 4 | Bauteilkit
G1 | Gehäuse | 3D-Druckteil | | 1 thingiverse (https://www.thingiverse.com/thing:4580425) | Bauteilkit

* Anmerkungen: Für den Betrieb an der LINK Platine muss das ESP32-Kit mit einer Stiftleiste versehen werden, also nicht wie bei Mini V1/V2 mit einer Buchsenleiste.

532
