WLANThermo/WLANThermo_Hardware/esp32 kit/bom/BOM WLANThermo ESP32-Kit.pdf

### BOM - WLANThermo ESP32-Upgrade-Kit

Version: | Jul 20
By: | s.ochs | https://wlanthermo.de

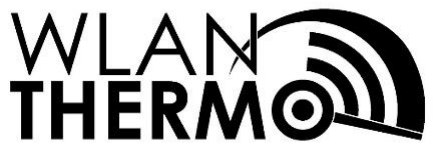
[picture p63: figure]

Kennung | Bauteilbezeichnung | Anmerkung | Größe | Menge Händler
IC1 | TLV75733PDBVR | Step Down 3V3 | SOT-23-5 | 1 Mouser (https://www.mouser.de/ProductDetail/texas-instruments/tlv75733pdbvr/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) | Bausatz / (https://wlanthermo.de/shop/esp32-upgrade-kit.41/) Mouser-WK (https://www.mouser.com/ProjectManager/ProjectDetail.aspx?AccessID=a1baec0101)
IC2 | CH340C | USB Interface | SOIC-16 | 1 ebay (https://www.ebay.de/itm/282260361291) | Bausatz
C1 | GRM31CD80J107ME39L | 100uF, 6.3V, 20% | SMD 1206 | 1 Mouser (https://www.mouser.de/ProductDetail/Murata-Electronics/GRM31CD80J107ME39L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) | Bausatz / Mouser-WK
C2 | GRM188R61A106KE69D | 10uF, 10V, 20%, X5R or X7R | SMD 0603 | 1 Mouser (https://www.mouser.de/ProductDetail/Murata-Electronics/GRM188R61A106KE69D) | Bausatz / Mouser-WK
C3 - C4 | CC0603KRX7R7BB105 | 1uF, 16V, 10%, X5R or X7R | SMD 0603 | 2 Mouser (https://www.mouser.de/ProductDetail/Yageo/CC0603KRX7R7BB105?qs=sGAEpiMZZMs0AnBnWHyRQNA8i4Zgtm9tZdFjY4F8SMc%3d) | Bausatz / Mouser-WK
C5 - C8 | CC0603KRX7R8BB104 | 100nF, 25V, 10% | SMD 0603 | 4 Mouser (https://www.mouser.de/ProductDetail/Yageo/CC0603KRX7R8BB104?qs=sGAEpiMZZMs0AnBnWHyRQMMzfhmH8IQXUZNM5PDuUEs%3d) | Bausatz / Mouser-WK
R1 - R3 | AC0603FR-0710KL | 10K, 1% | SMD 0603 | 3 Mouser (https://www.mouser.de/ProductDetail/Yageo/AC0603FR-0710KL?qs=UoPT7wUmgYKz3zh0UDMA4Q%3D%3D) | Bausatz / Mouser-WK
R4 | RC0603FR-131KL | 1K, 1% | SMD 0603 | 1 Mouser (https://www.mouser.de/ProductDetail/Yageo/RC0603FR-131KL?qs=sGAEpiMZZMu61qfTUdNhG6gKAQVNBKOoufYlsdrS46Y%3d) | Bausatz / Mouser-WK
T1 | UMH3N | Dual-NPN | UMT-6 | 1 Mouser (https://www.mouser.de/ProductDetail/ROHM-Semiconductor/UMH3NTN?qs=4kLU8WoGk0st6ahJ6z2bmw%3D%3D) | Bausatz / Mouser-WK
D1 | APT1608CGCK | SMD LED Green | SMD 0603 | 1 Mouser (https://www.mouser.de/ProductDetail/Kingbright/APT1608CGCK?qs=VdjlWU%2FzoOFSew86JUt6QA%3D%3D) | Bausatz / Mouser-WK
S1 | SKRKAGE020 | Tact Switch 4X3X2mm | SMD | 1 Mouser (https://www.mouser.de/ProductDetail/ALPS/SKRKAGE020?qs=sGAEpiMZZMsgGjVA3toVBD6gd7ry65K63iGSdIYCoNM%3D) | Bausatz / Mouser-WK
K1 * | 61304021821 | Socket Heade 2X20, gerade, H: 8,5mm RM 2.54 | 1 Mouser (https://www.mouser.de/ProductDetail/Wurth-Elektronik/61304021821?qs=bZr6mbWTK5mzEvTTGhcEyQ%3D%3D) | Bausatz / Mouser-WK
K2 | 10118192-0001LF | Micro-USB Connector | SMD | 1 Mouser (http://www.mouser.de/Search/ProductDetail.aspx?qs=Ywefl8B65e5bHFoQtIudZg%3d%3d) | Bausatz / Mouser-WK
X1 | ESP32-WROOM-32D (16MB) ESP32 WLAN-Modul, PCB-Antenne | SMD | 1 Mouser (https://www.mouser.de/ProductDetail/Espressif-Systems/ESP32-WROOM-32D-16MB) | Bausatz / Mouser-WK
X1 (Alternative) * | ESP32-WROOM-32U (16MB) ESP32 WLAN-Modul, U.FL. Connector | SMD | 1 Mouser (https://www.mouser.de/ProductDetail/Espressif-Systems/ESP32-WROOM-32U-16MB) | Bausatz
X2 | | Micro SD Card Socket | SMD | 1 Aliexpress (https://de.aliexpress.com/item/32906952129.html?spm=a2g0s.9042311.0.0.27424c4dFa6Sp3) | Bausatz
X4 | E104-BT5032A | eByte nRF52832 BT-Modul | SMD | 1 eByte (http://www.ebyte.com/en/product-view-news.aspx?id=756) | Bausatz
P1 | Platine | 1 mm Platinendicke | | 1 github | Bausatz

* Anmerkungen: Die Verwendung von X1 mit PCB-Antenne ist für alle Mini V1/V2 mit 3D-Druck- und Holzgehäuse geeignet. Die Version mit U.FL. Connector ist für den Einsatz in einem Aluminiumgehäuse, zusammen mit einer externen Antenne, gedacht. Standardmäßig sind die Mini V1 und V2 Platinen mit einer 40-Pin Stiftleiste versehen auf die das ESP32-Kit dann mit der 40-Pin Buchsenleiste aufgesteckt werden kann. Bitte vorher kontrollieren, dass dies der Fall ist.

enthalten in
