WLANThermo/WLANThermo_Hardware/mini v2/bom/BOM WLANThermo Mini v2.pdf

### BOM - WLANThermo Mini v2

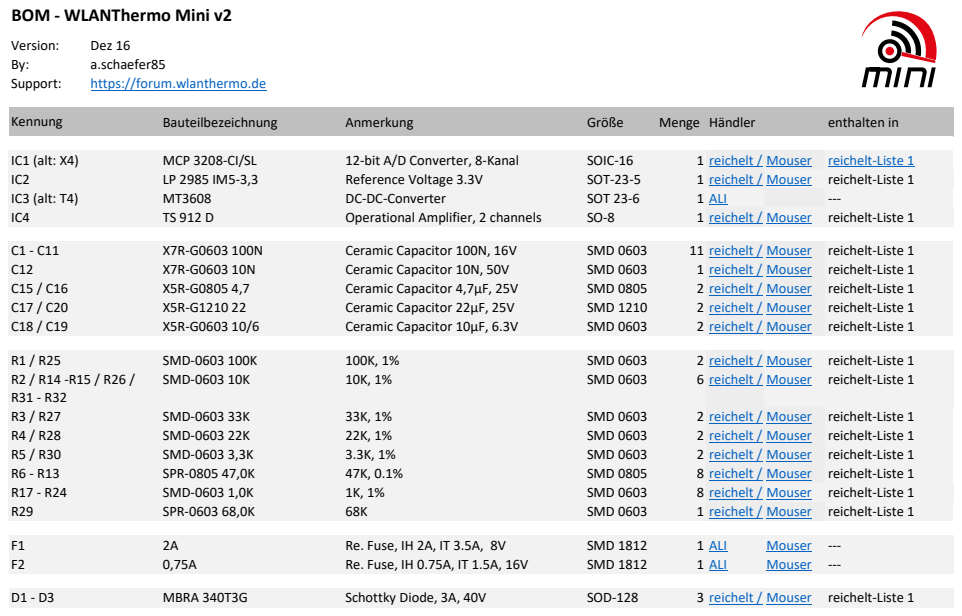
[picture p64: page 1]

IC1 (alt: X4) MCP 3208-CI/SL 12-bit A/D Converter, 8-Kanal SOIC-16 1 | reichelt / (https://www.reichelt.de/MCP-3208-CI-SL/3/index.html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) Mouser (https://www.mouser.de/ProductDetail/Microchip-Technology/MCP3208T-CI-SL/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) | reichelt-Liste 1 (https://www.reichelt.de/my/1477922)
IC2 LP 2985 IM5-3,3 Reference Voltage 3.3V SOT-23-5 1 | reichelt / (https://www.reichelt.de/LP-2985-IM5-3-3/3/index.html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) Mouser (https://www.mouser.de/ProductDetail/Texas-Instruments/LP2985IM5-33-NOPB/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) reichelt-Liste 1
IC3 (alt: T4) MT3608 DC-DC-Converter SOT 23-6 1 ALI (https://de.aliexpress.com/item/Free-shipping-10pcs-lot-MT3608-B628-synchronous-boost-converter-DC-DC-converter-SOT23-6-new/32699243954.html) | | ---
IC4 TS 912 D Operational Amplifier, 2 channels SO-8 1 | reichelt / (https://www.reichelt.de/TS-912-D/3/index.html?ACTION=3&LA=446&ARTICLE=39801&artnr=TS+912+D&SEARCH=TS+912) Mouser (https://www.mouser.de/ProductDetail/STMicroelectronics/TS912IDT/) reichelt-Liste 1

R17 - R24 SMD-0603 1,0K 1K, 1% SMD 0603 8 | reichelt / (https://www.reichelt.de/SMD-0603-1-0K/3/index.html?ACTION=3&GROUPID=7968&ARTICLE=89430&START=0&OFFSET=16) Mouser (http://www.mouser.de/ProductDetail/Yageo/RC0603FR-071KL/) reichelt-Liste 1
R29 SPR-0603 68,0K 68K SMD 0603 1 | reichelt / (https://www.reichelt.de/SMD-0603-von-1-bis-910-kOhm/SPR-0603-68-0K/3/index.html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) Mouser (https://www.mouser.de/ProductDetail/Yageo/RC0603FR-1068KL?qs=sGAEpiMZZMvdGkrng054t9qRi46YuxR08AHjOtX20j0%3d) | reichelt-Liste 1

T1 - T2 2SC3303 NPN TO-252-3 2 T3 BC 848B SMD NPN SOT-23-3 1 | reichelt (https://www.reichelt.de/2SC-Transistoren/SC-3303/3/index.html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) reichelt (https://www.reichelt.de/BC-848B-SMD/3/index.html?ACTION=3&LA=446&ARTICLE=18565&artnr=BC+848B+SMD&SEARCH=BC848) | reichelt-Liste 1 reichelt-Liste 1
T5 - T6 BSS138 SMD MOSFET N-CH LOGIC SOT-23-3 2 | reichelt / (https://www.reichelt.de/BS-Transistoren/BSS-138-SMD/3/index.html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) Mouser (http://www.mouser.de/ProductDetail/Fairchild-Semiconductor/BSS138/?qs=sGAEpiMZZMvlOED0T0kTWl5MKyjMqq%2fg) reichelt-Liste 1
L1 | L-PIS4720 22µ | SMD-Power-Induktivität, Ferrit, 22µ | 12x12x6 | 1 | reichelt / (https://www.reichelt.de/L-PIS4720-22-/3/index.html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) Mouser (https://www.mouser.de/ProductDetail/Murata-Power-Solutions/47220SC/) | reichelt-Liste 1
AL1 | AI-1027-TWT-5V-2-R | SUMMER | | 1 | Mouser / (https://www.mouser.de/ProductDetail/PUI-Audio/AI-1027-TWT-5V-2-R/) conrad (https://www.conrad.de/de/piezo-signalgeber-geraeusch-entwicklung-80-db-spannung-5-v-dauerton-kepo-kpx-g0905b-6334-1-st-710886.html) | ---
K1 / K14 | SL 2X40G 2,54 | Stiftleiste, 2X40, gerade | RM 2.54 | 1 reichelt (https://www.reichelt.de/SL-2X40G-2-54/3/index.html?ACTION=3&LA=55&ARTICLE=19498) | reichelt- Liste 2 (https://www.reichelt.de/my/1477935)
BL 1X20G8 2,54 | Buchsenleiste, 1X20, gerade, H: 8,5mm RM 2.54 | 2 reichelt (https://www.reichelt.de/BL-1X20G8-2-54/3/index.html?ACTION=3&LA=55&ARTICLE=51827) | reichelt- Liste 2
K2 - K10 | PS 25/2G WS | Steckverbinder, gerade, weiß, 2-polig | RM 2.54 | 9 reichelt (https://www.reichelt.de/PS-25-2G-WS/3/index.html?ACTION=3&LA=55&ARTICLE=14825) | reichelt- Liste 2
K11 | SL 1X40W 2,54 | Stiftleiste, 1x40, gewinkelt | 1 reichelt (https://www.reichelt.de/Stiftleisten/SL-1X40W-2-54/3/index.html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) | reichelt- Liste 2
2.8" Nextion TFT | HMI Display ENHANCED | 1 komputer (http://www.komputer.de/zen/index.php?main_page=product_info&cPath=30&products_id=384) | ---
K12 / K13 | PSS 254/5W | Einzelstecker, gewinkelt, 5-polig | 2 reichelt (https://www.reichelt.de/PSS-254-5W/3/index.html?ACTION=3&GROUPID=7525&ARTICLE=14912&START=0&OFFSET=500) | reichelt- Liste 2
PS 25/5G WS | Steckverbinder, gerade, weiss, 5-polig | 2 reichelt (https://www.reichelt.de/Platinen-Steckverbinder/PS-25-5G-WS/3/index.html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) | reichelt- Liste 2
K15 / K16 | 433MHz-Funkmodul | 1 amazon (https://www.amazon.de/gp/product/B06XHJMC82/?tag=wlanthermo-21) | optional
433MHz-Antenne | 1 amazon (https://www.amazon.de/gp/product/B00SO651VU/?tag=wlanthermo-21) | optional
K17 | MPE 087-1-020 | Stiftleisten, 1x20, gerade | RM 2.54 | 1 reichelt (https://www.reichelt.de/MPE-087-1-020/3/index.html?ACTION=3&LA=55&ARTICLE=119888) | reichelt- Liste 2
B1 | HEBL 21 | Hohlstecker-Buchse, Øi= 2,1mm | 1 reichelt (https://www.reichelt.de/HEBL-21/3/index.html?ACTION=3&LA=55&ARTICLE=8524) | reichelt- Liste 2
B2 | HS 21-9 | Hohlstecker, Øi= 2,1mm Øa=5,5mm | 1 reichelt (https://www.reichelt.de/HS-21-9/3/index.html?ACTION=3&LA=55&ARTICLE=8647) | reichelt- Liste 2
B3 | REAN T5MPR | TINY xlr Einbaustecker, 5-pol | 2 reichelt (https://www.reichelt.de/XLR-Einbaubuchsen-stecker/REAN-T5MPR/3/index.html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) | reichelt- Liste 2
B4 | REAN T5FC-B | TINY xlr Kabelbuchse, 5-pol | 2 reichelt (https://www.reichelt.de/Kupplungen/REAN-T5FC-B/3/index.html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) | reichelt- Liste 2
B5 | LUM KLB 1 | 2,5mm Mono Klinkenbuchse, Öffner | 8 reichelt (https://www.reichelt.de/LUM-KLB-1/3/index.html?ACTION=3&LA=55&ARTICLE=116163) | reichelt- Liste 2
X1 | Raspberry Pi Zero | nicht Zero W | 1 pimoroni (https://shop.pimoroni.com/products/raspberry-pi-zero) | ---
X2 | WLAN-Adapter | EDIMAX EW-7811UN | 1 reichelt (https://www.reichelt.de/WLAN-Adapter/EDIMAX-EW-7811UN/3/index.html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) | ---
X3 | USB-A-Buchse | USB Type A Female Breakout | 1 pimoroni (https://shop.pimoroni.de/products/sparkfun-usb-type-a-female-breakout) | ---
X4 | Mirco-USB-Buchse | USB Micro-B Breakout Board | 1 amazon (https://www.amazon.de/dp/B012C6PKXG/?tag=wlanthermo-21) | ---
X5 | Micro-USB-Stecker | Alternativ ein Micro-USB-Kabel | 1 pimoroni (https://shop.pimoroni.com/products/usb-to-microusb-otg-converter-shim) | ---
X6 | SD-Karte | microSDHC 8GB | 1 amazon (https://www.amazon.de/dp/B073S9SFK2/?tag=wlanthermo-21) | ---
X7 | Netzteil | 5V, mind. 2A, Micro-USB | 1 reichelt (https://www.reichelt.de/Ladegeraete-fuer-USB-Geraete/NT-MUSB-2-SW/3/index.html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) | optional
X8 | CR1220 | 3V Knopfzelle für RTC Modul des TFT | 1 amazon (https://www.amazon.de/dp/B00005NPS7/?tag=wlanthermo-21) | ---

M1 | Schraube M4x10 | ISO 7380-1 | 4 | Schrauben-Set (https://www.wlanthermo-shop.com/shop/bauteile/schrauben/#cc-m-product-11133174193)
M2 | Mutter M4 | DIN 934 | 4 | Schrauben-Set
| U-Scheibe M4 | DIN 125, 4.3 mm | 4 | Schrauben-Set
M3 | Schraube M3x16 | ISO 7380-1 | 2 | Schrauben-Set
| Schraube M3x8 | ISO 7380-1 | 2 | Schrauben-Set
| Schraube M3x4 | ISO 7380-1 | 8 | Schrauben-Set
M4 | Mutter M3 | DIN 934 | 12 | Schrauben-Set
M5 | U-Scheibe M3 | DIN 125, 4.3 mm | 4 | Schrauben-Set
| Scheibenmagnet 20x3 | Neodym | 2 | Schrauben-Set
| Gerätefüße | Ø 9 mm, schwarz | 4 | Schrauben-Set
M6 | Abstandshalter | Add-On Platine | 2 | Schrauben-Set
P1 | Platine | 0,8 mm Platinendicke | 1 github | ---
G1 | Gehäuse | | 1 github | ---

Bemerkung:
1. Eine bestückte SMD-Platine beinhaltet die Komponenten P1, IC3, F1, F2, AL1 sowie alle Bauteile der reichelt-Liste 1 und kann im Shop erworben werden.
2. Zur Vervollständigung einer bestückten SMD Platine werden die Komponenten aus der reichelt-Liste 2 benötigt.
3. Neben den bestückten SMD-Platinen gibt es im Shop auch komplette Bauteil-Sets sowie einzelne Komponenten und ein Schrauben-Set.
