WLANThermo/WLANThermo_Hardware/mini v1/case/j3di/Deckel_Anschluss_links_mittig_rechts_J3DI_mod_v1_2.STL

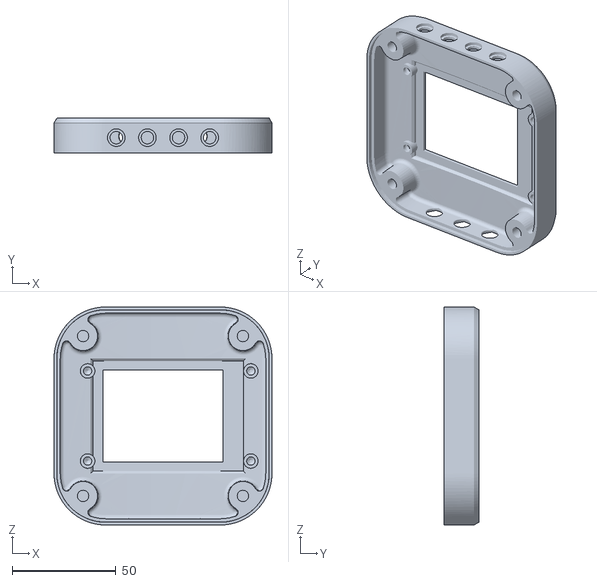
[picture p65: CAD file, 2016-02-15, an earlier design]
mini v1/case/j3di/Deckel_Anschluss_links_mittig_rechts_J3DI_mod_v1_2.STL
105.0 x 17.1 x 105.0
