WLANThermo/WLANThermo_Hardware/mini v1/case/maloriak/v2/SCAD/originalgehaeuse_20160209/Deckel_oben_Anschluss_li_re_mi.stl

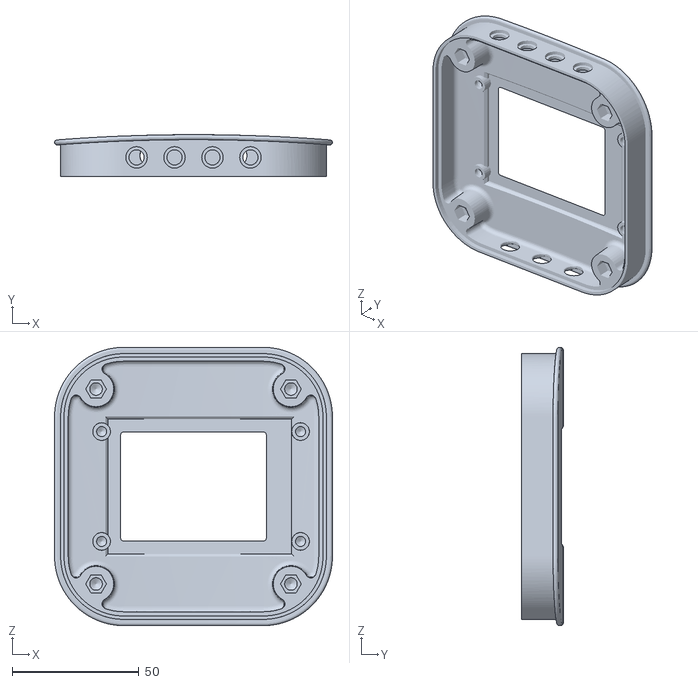
[picture p66: CAD file, 2016-02-15, an earlier design]
mini v1/case/maloriak/v2/SCAD/originalgehaeuse_20160209/Deckel_oben_Anschluss_li_re_mi.stl
109.8 x 16.5 x 110.0
