WLANThermo/WLANThermo_Hardware/mini v1/case/maloriak/v2/STL/WTM_Boden_V22.stl

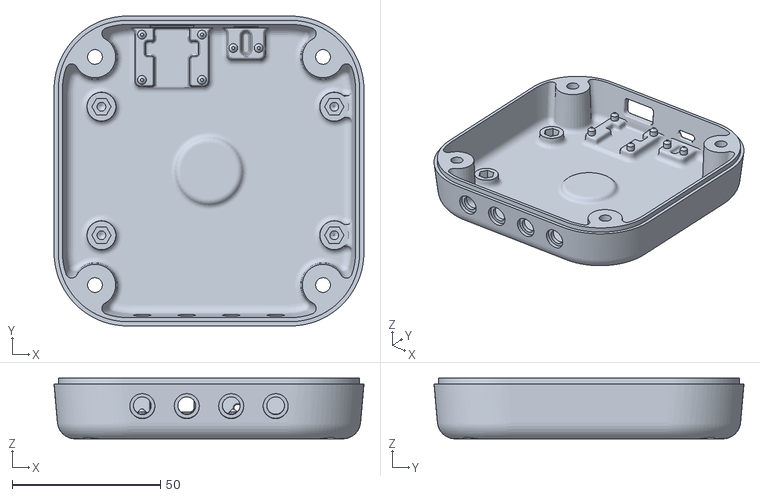
[picture p67: CAD file, 2016-02-15, an earlier design]
mini v1/case/maloriak/v2/STL/WTM_Boden_V22.stl
104.7 x 104.7 x 20.5
