WLANThermo/WLANThermo_Hardware/mini v1/case/maloriak/v2/STL_mit_Warp/WTM_Deckel_LR_warp_V22.stl

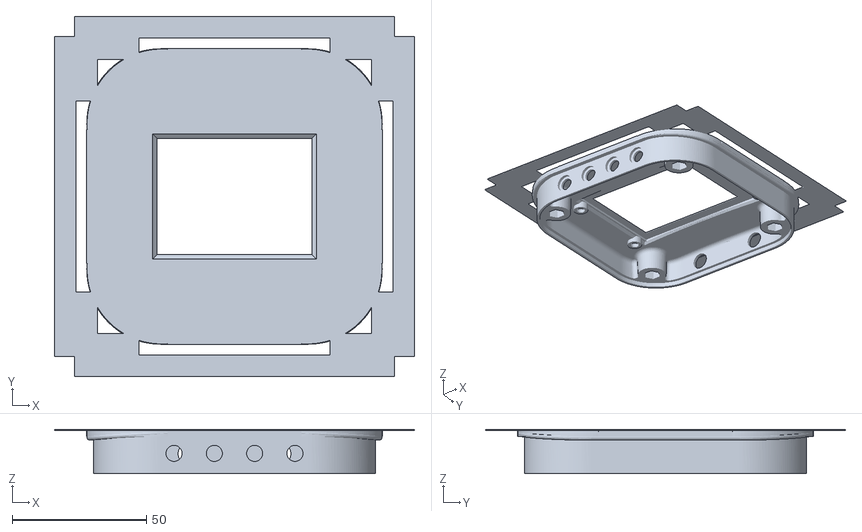
[picture p68: CAD file, 2016-02-15, an earlier design]
mini v1/case/maloriak/v2/STL_mit_Warp/WTM_Deckel_LR_warp_V22.stl
134.0 x 134.0 x 16.4
