WLANThermo/WLANThermo_Hardware/mini v1/case/maloriak/v3/STL/WTM_Boden_V37.stl

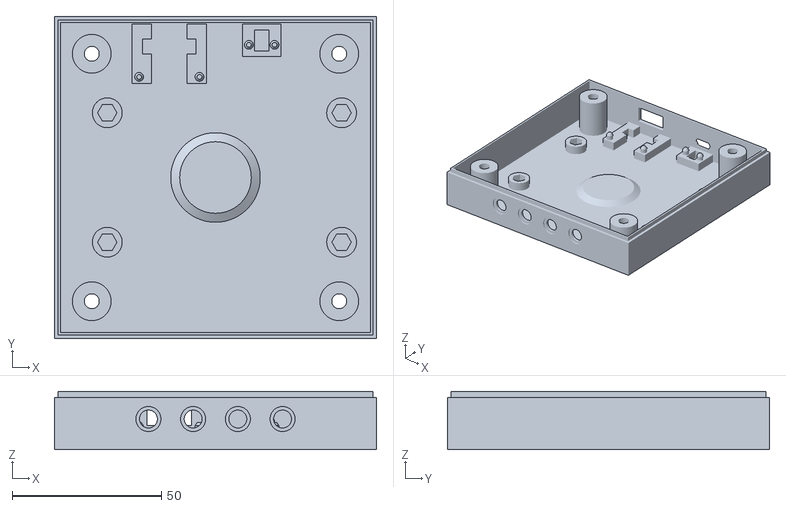
[picture p69: CAD file, 2016-02-15, an earlier design]
mini v1/case/maloriak/v3/STL/WTM_Boden_V37.stl
108.0 x 108.0 x 19.5
