WLANThermo/WLANThermo_Hardware/mini v1/case/maloriak/v3/STL_mit_Beschriftung_und_Warp/WTM_Boden_B_warp_V37.stl

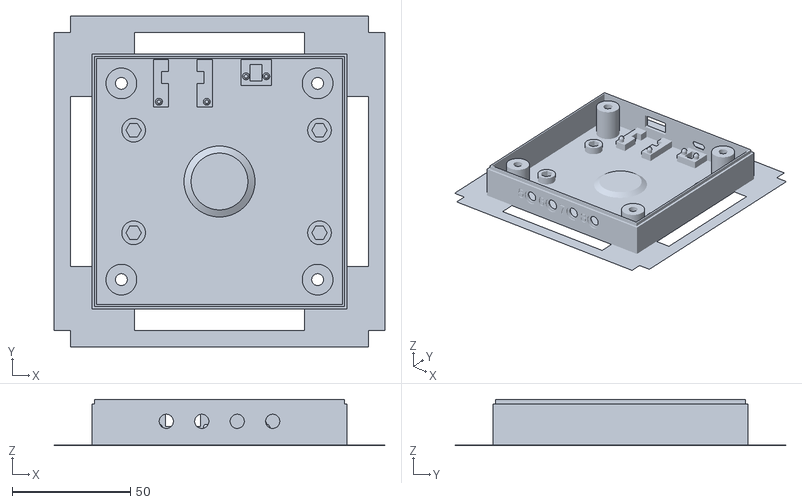
[picture p70: CAD file, 2016-02-15, an earlier design]
mini v1/case/maloriak/v3/STL_mit_Beschriftung_und_Warp/WTM_Boden_B_warp_V37.stl
140.0 x 140.0 x 19.5
