WLANThermo/WLANThermo_Hardware/mini v1/case/maloriak/v3/STL_mit_Warp/WTM_Deckel_LMR_warp_V37.stl

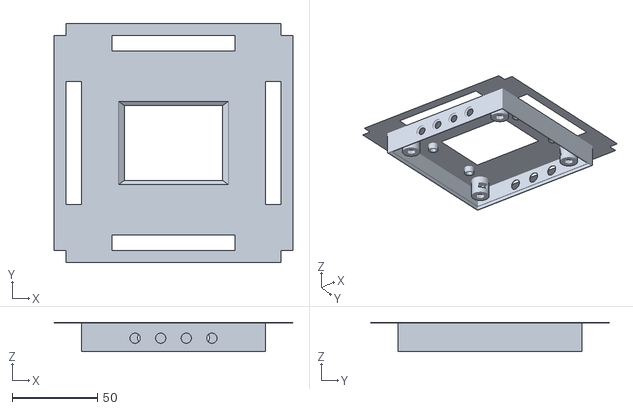
[picture p71: CAD file, 2016-02-15, an earlier design]
mini v1/case/maloriak/v3/STL_mit_Warp/WTM_Deckel_LMR_warp_V37.stl
140.0 x 140.0 x 17.0
