WLANThermo/WLANThermo_Hardware/mini v1/case/original/scad/Deckel_4_Anschluesse.stl

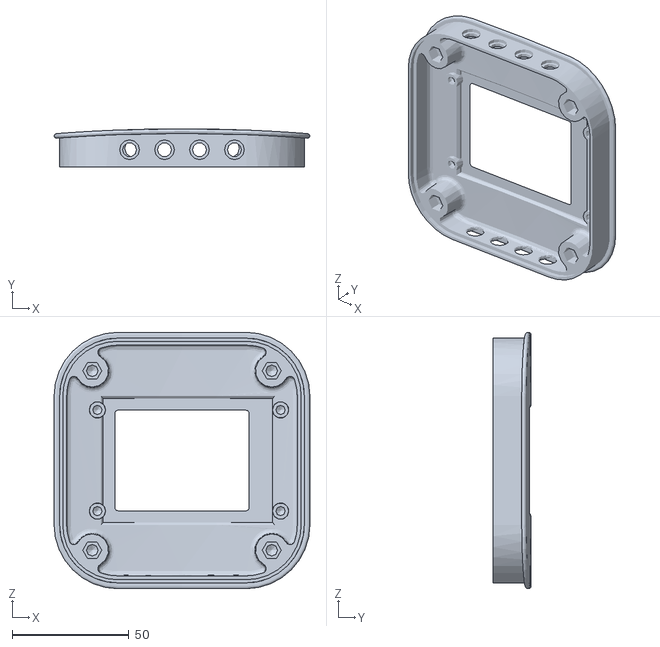
[picture p72: CAD file, 2018-04-26, an earlier design]
mini v1/case/original/scad/Deckel_4_Anschluesse.stl
109.8 x 16.5 x 110.0
