WLANThermo/WLANThermo_Hardware/mini v1/case/ressources/Display 2,8.stp

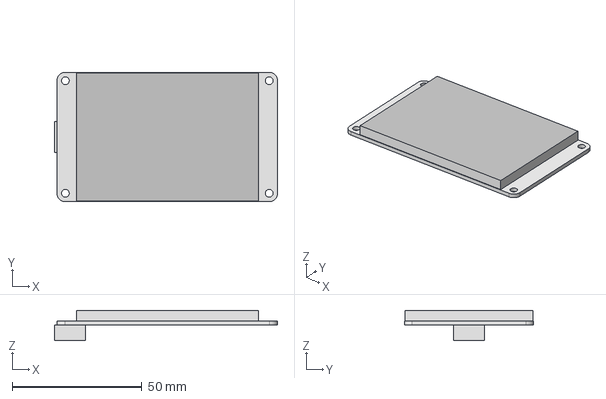
[picture p73: CAD file, 2016-02-15, an earlier design]
mini v1/case/ressources/Display 2,8.stp
86.0 x 49.8 x 11.7 mm
