WLANThermo/WLANThermo_Hardware/mini v2/step/Add-On Platine/PCC-SMP Buchse/PCC-SMP.STEP

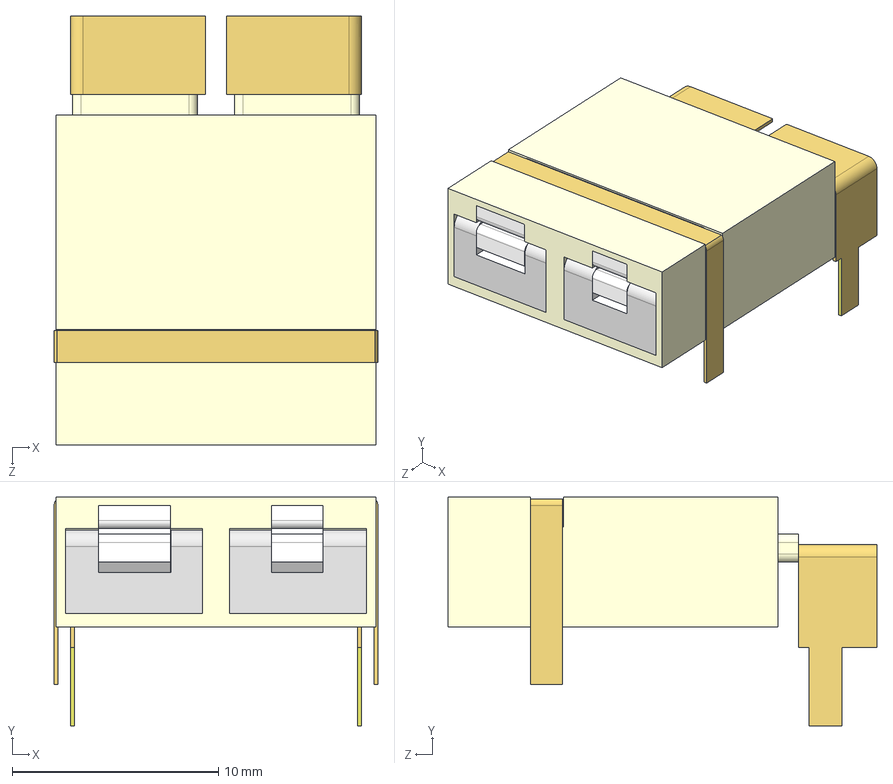
[picture p74: CAD file, 2018-04-28, an earlier design]
mini v2/step/Add-On Platine/PCC-SMP Buchse/PCC-SMP.STEP
15.7 x 11.1 x 20.8 mm
