WLANThermo/WLANThermo_Hardware/mini v2/step/Add-On Platine/Stecker Thermocouple/thermocouplemale.STEP

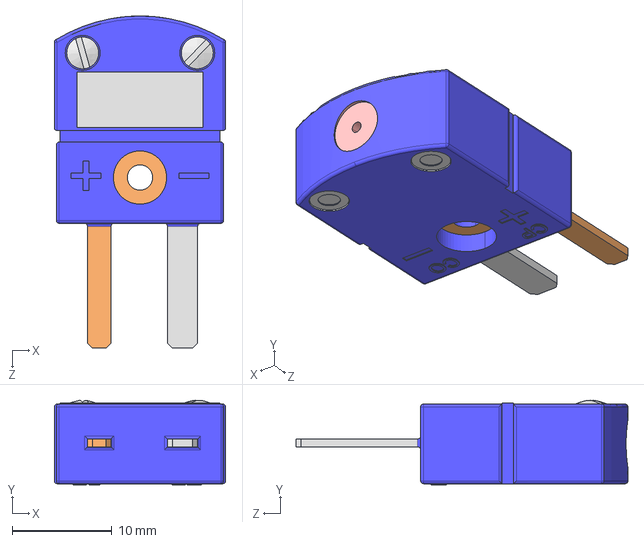
[picture p75: CAD file, 2018-04-28, an earlier design]
mini v2/step/Add-On Platine/Stecker Thermocouple/thermocouplemale.STEP
17.2 x 8.48 x 33.3 mm
