WLANThermo/WLANThermo_Hardware/mini v2/step/Buchsen/HEBL 21.stp

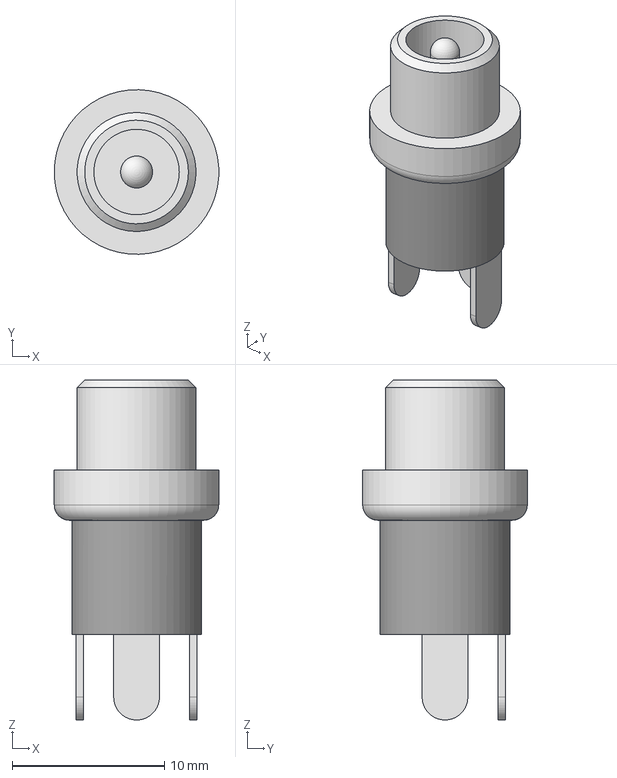
[picture p76: CAD file, 2018-04-28, an earlier design]
mini v2/step/Buchsen/HEBL 21.stp
10.8 x 10.8 x 22.3 mm
