WLANThermo/WLANThermo_Hardware/mini v2/step/Display/LCD mit schwarzem Bildschirm v1.stp

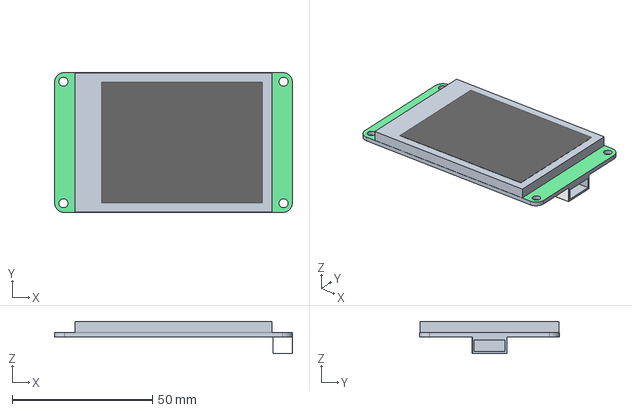
[picture p77: CAD file, 2018-04-28, an earlier design]
mini v2/step/Display/LCD mit schwarzem Bildschirm v1.stp
85.0 x 50.0 x 11.5 mm
