WLANThermo/WLANThermo_Hardware/mini v2/step/FunkempfÑnger/Antenne Funk.step

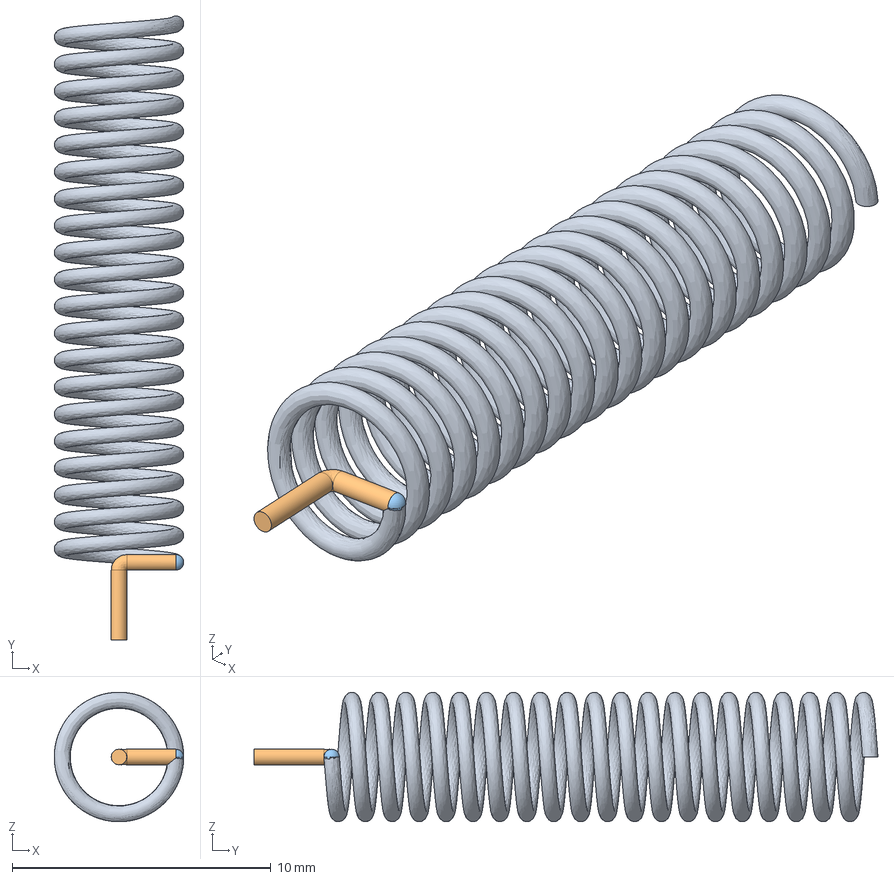
[picture p78: CAD file, 2018-04-28, an earlier design]
mini v2/step/FunkempfÑnger/Antenne Funk.step
5.00 x 24.1 x 5.00 mm
