WLANThermo/WLANThermo_Hardware/mini v2/step/Gehäuse/WLTMV2-case_plug.STEP

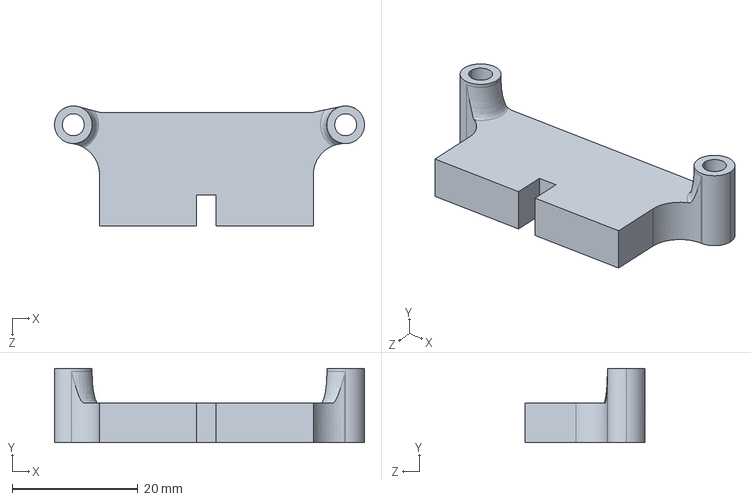
[picture p79: CAD file, 2018-04-28, an earlier design]
mini v2/step/Gehäuse/WLTMV2-case_plug.STEP
49.4 x 11.8 x 19.2 mm
