WLANThermo/WLANThermo_Hardware/mini v2/step/Raspberry Zero/Buchsenleiste.stp

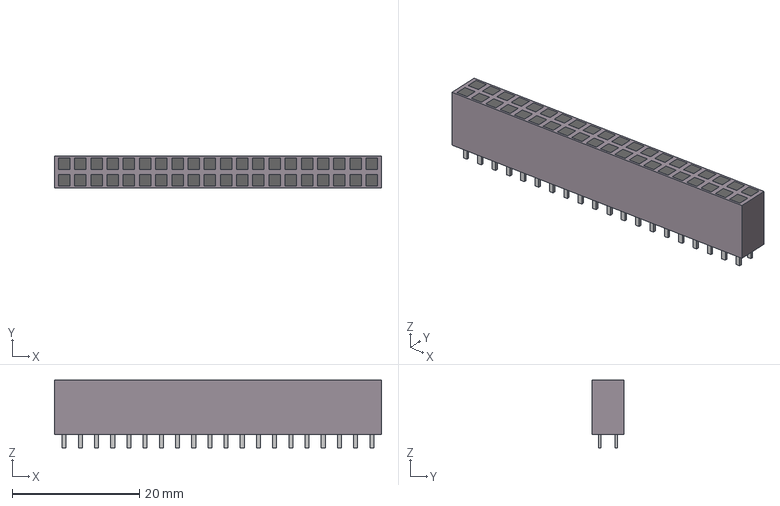
[picture p80: CAD file, 2018-04-28, an earlier design]
mini v2/step/Raspberry Zero/Buchsenleiste.stp
51.3 x 5.00 x 10.6 mm
