WLANThermo/WLANThermo_Hardware/mini v2/step/USB Breadboard/kauf USB Breadboards/USB Micro Breakout.stp

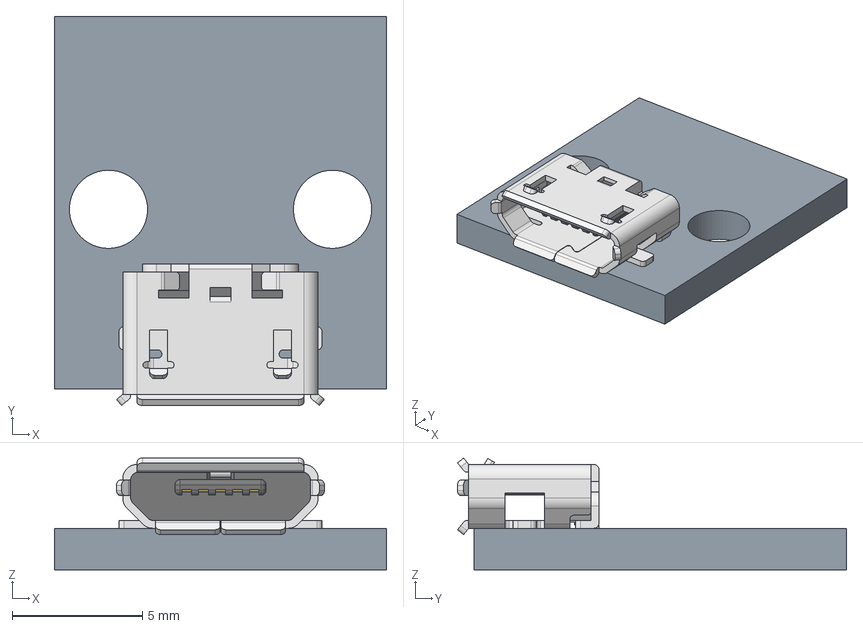
[picture p81: CAD file, 2016-02-24, an earlier design]
mini v2/step/USB Breadboard/kauf USB Breadboards/USB Micro Breakout.stp
12.8 x 14.9 x 4.29 mm
Platine
micro_usb_47346-0001
