WLANThermo/WLANThermo_Hardware/(list of files, cad)

Other CAD files:
mini v1/case/original/Halter_Innenleben.stp
mini v1/case/maloriak/v2/SCAD/WTM_MaloriakV22.scad
mini v1/case/maloriak/v3/SCAD/WTM_MaloriakV37.scad
mini v1/case/j3di/Deckel_Anschluss_mittig_J3DI_mod.STL
mini v1/case/j3di/Deckel_ohne_Anschluss_J3DI_mod.STL
mini v1/case/j3di/Halter_Innenleben_J3DI_mod_v1_2.stl
mini v1/case/maloriak/v2/SCAD/originalgehaeuse_20160209/Deckel_oben_Anschluss_li_re.stl
mini v1/case/maloriak/v2/SCAD/originalgehaeuse_20160209/Deckel_oben_Anschluss_mittig.stl
mini v1/case/maloriak/v2/SCAD/originalgehaeuse_20160209/Gehaeuse_Innenleben.stl
mini v1/case/maloriak/v2/STL/WTM_Deckel_LMR_V22.stl
mini v1/case/maloriak/v2/STL/WTM_Deckel_LR_V22.stl
mini v1/case/maloriak/v2/STL/WTM_Deckel_M_V22.stl
mini v1/case/maloriak/v2/STL/WTM_Deckel_V22.stl
mini v1/case/maloriak/v2/STL_mit_Warp/WTM_Boden_warp_V22.stl
mini v1/case/maloriak/v2/STL_mit_Warp/WTM_Deckel_LMR_warp_V22.stl
mini v1/case/maloriak/v2/STL_mit_Warp/WTM_Deckel_M_warp_V22.stl
mini v1/case/maloriak/v2/STL_mit_Warp/WTM_Deckel_warp_V22.stl
mini v1/case/maloriak/v3/STL/WTM_Deckel_LMR_V37.stl
mini v1/case/maloriak/v3/STL/WTM_Deckel_LR_V37.stl
mini v1/case/maloriak/v3/STL/WTM_Deckel_M_V37.stl
mini v1/case/maloriak/v3/STL/WTM_Deckel_V37.stl
mini v1/case/maloriak/v3/STL_mit_Beschriftung_und_Warp/WTM_Deckel_B_M_warp_V37.stl
mini v1/case/maloriak/v3/STL_mit_Warp/WTM_Boden_warp_V37.stl
mini v1/case/maloriak/v3/STL_mit_Warp/WTM_Deckel_LR_warp_V37.stl
mini v1/case/maloriak/v3/STL_mit_Warp/WTM_Deckel_M_warp_V37.stl
mini v1/case/maloriak/v3/STL_mit_Warp/WTM_Deckel_warp_V37.stl
mini v1/case/original/Deckel_Anschluss_links_mittig_rechts.stp
mini v1/case/original/Deckel_Anschluss_links_rechts.stp
mini v1/case/original/Deckel_Anschluss_mittig.stp
mini v1/case/original/Deckel_ohne_Anschluss.stp
mini v1/case/original/Quelldatein/Deckel_oben.CATPart
mini v1/case/original/Quelldatein/Halter_Innenleben.CATPart
mini v1/case/original/scad/Deckel_oben_Anschluss_li_re.stl
mini v1/case/original/scad/Deckel_oben_Anschluss_mittig.stl
mini v1/case/original/scad/Deckel_oben_Ohne_Anschluss.stl
mini v1/case/original/scad/Gehaeuse_Innenleben.stl
mini v2/step/Buchsen/HEBL 21 Mutter.stp
mini v2/step/Buchsen/KLB 1 Mutter.stp
mini v2/step/Buchsen/KLB 1.stp
mini v2/step/Buchsen/LUM 1502-02 Mutter.stp
mini v2/step/Buchsen/LUM 1502-02.stp
mini v2/step/Buchsen/REAN K4MPR Buchse - J3DI.STEP
mini v2/step/Buchsen/REAN K4MPR Mutter - J3DI.STEP
mini v2/step/FunkempfÑnger/RXB6.stp
mini v2/step/Gehäuse/WLTMV2-case_bottom_J3DI_v1_0r.STEP
mini v2/step/Gehäuse/WLTMV2-case_top_J3DI_v1_0_1r.STEP
mini v2/step/USB Breadboard/Masshaltige Buchsen/Micro USB.STEP
mini v2/step/USB Breadboard/Masshaltige Buchsen/USB A.stp
mini v2/step/USB Breadboard/kauf USB Breadboards/USB_Type_A_Female_Breakout.stp
