WLANThermo/WLANThermo_Hardware/esp32 kit/circuit/Schaltplan WT ESP32-Kit_052020.pdf

IC2

A

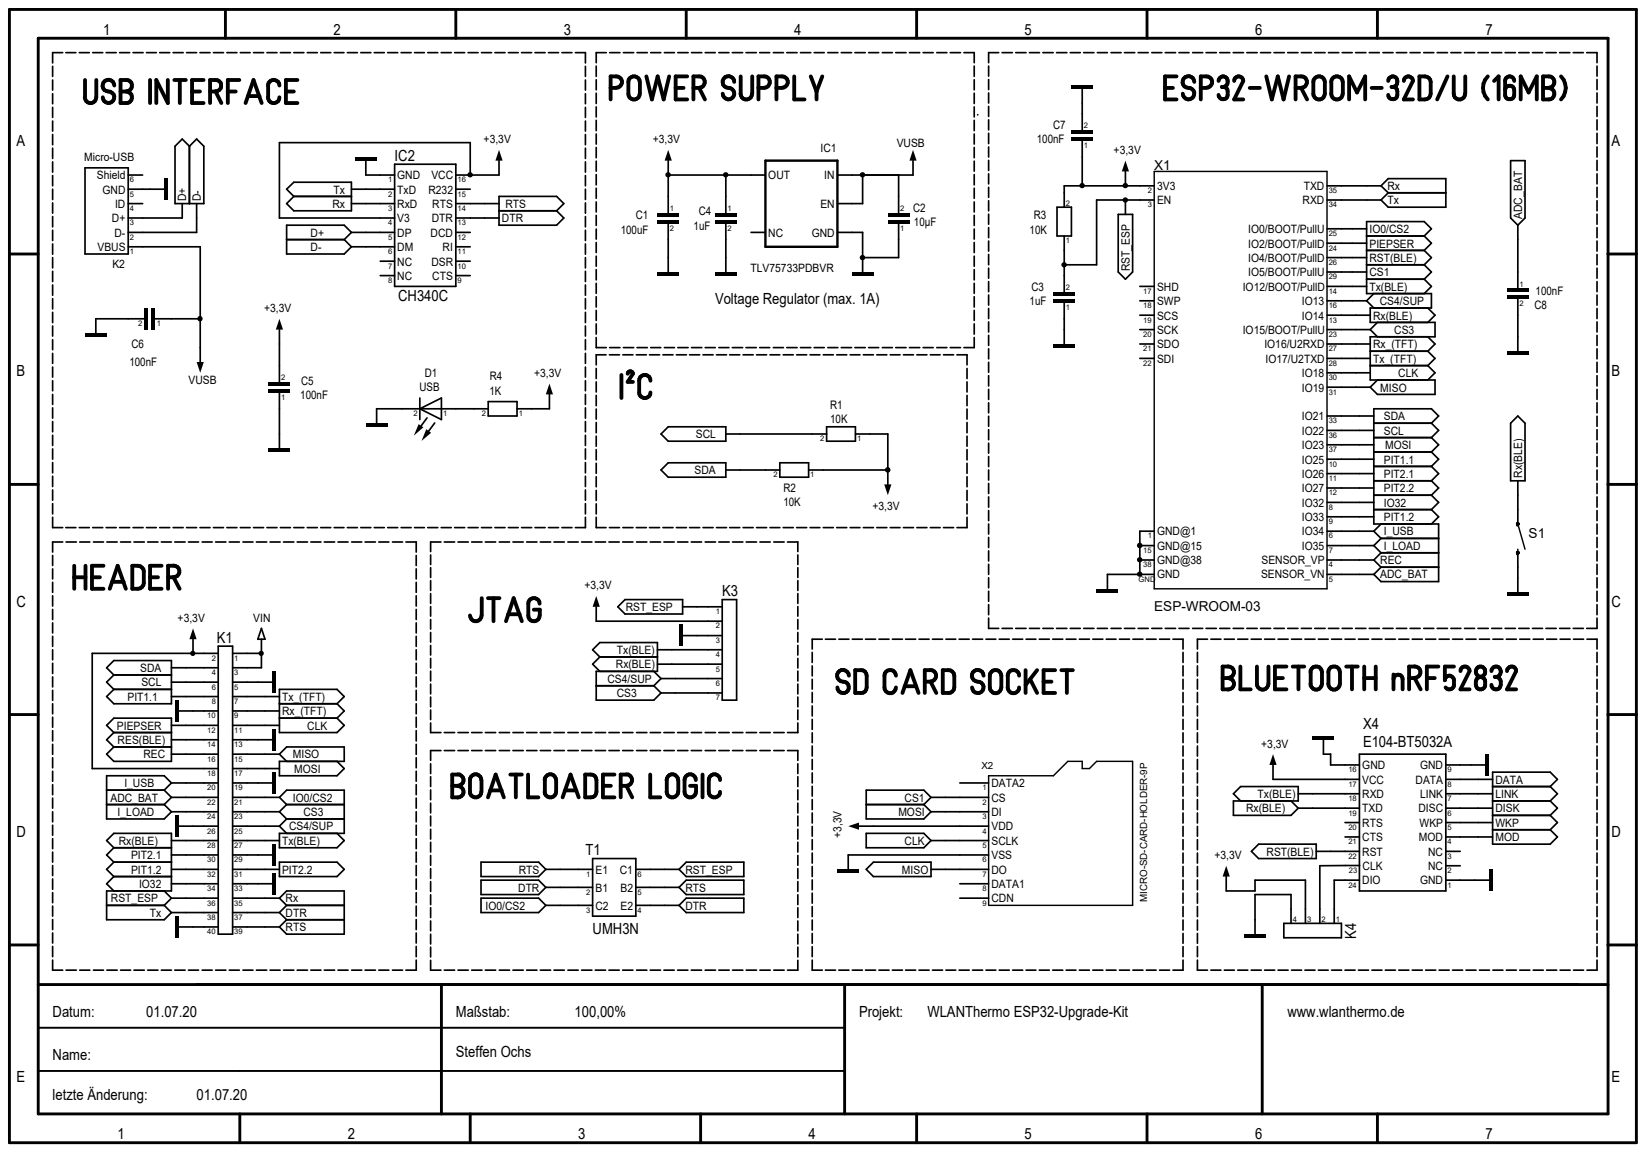
[picture p92: page 1]

DTR | RTS

RST_ESP | Rx

IO0/CS2 | DTR

Tx | DTR

Datum: 01.07.20 | Maßstab: 100,00% | Projekt: WLANThermo ESP32-Upgrade-Kit | www.wlanthermo.de

Name: | Steffen Ochs

letzte Änderung: 01.07.20
