WLANThermo/WLANThermo_Hardware/mini v3/circuit/WLANThermo Mini_v3_052021_Schaltplan(beta).pdf

CHANNEL 5 | CHANNEL 7 | CHANNEL 6 | CHANNEL 8
CHANNEL 1 | CHANNEL 2 | CHANNEL 3 | CHANNEL 4

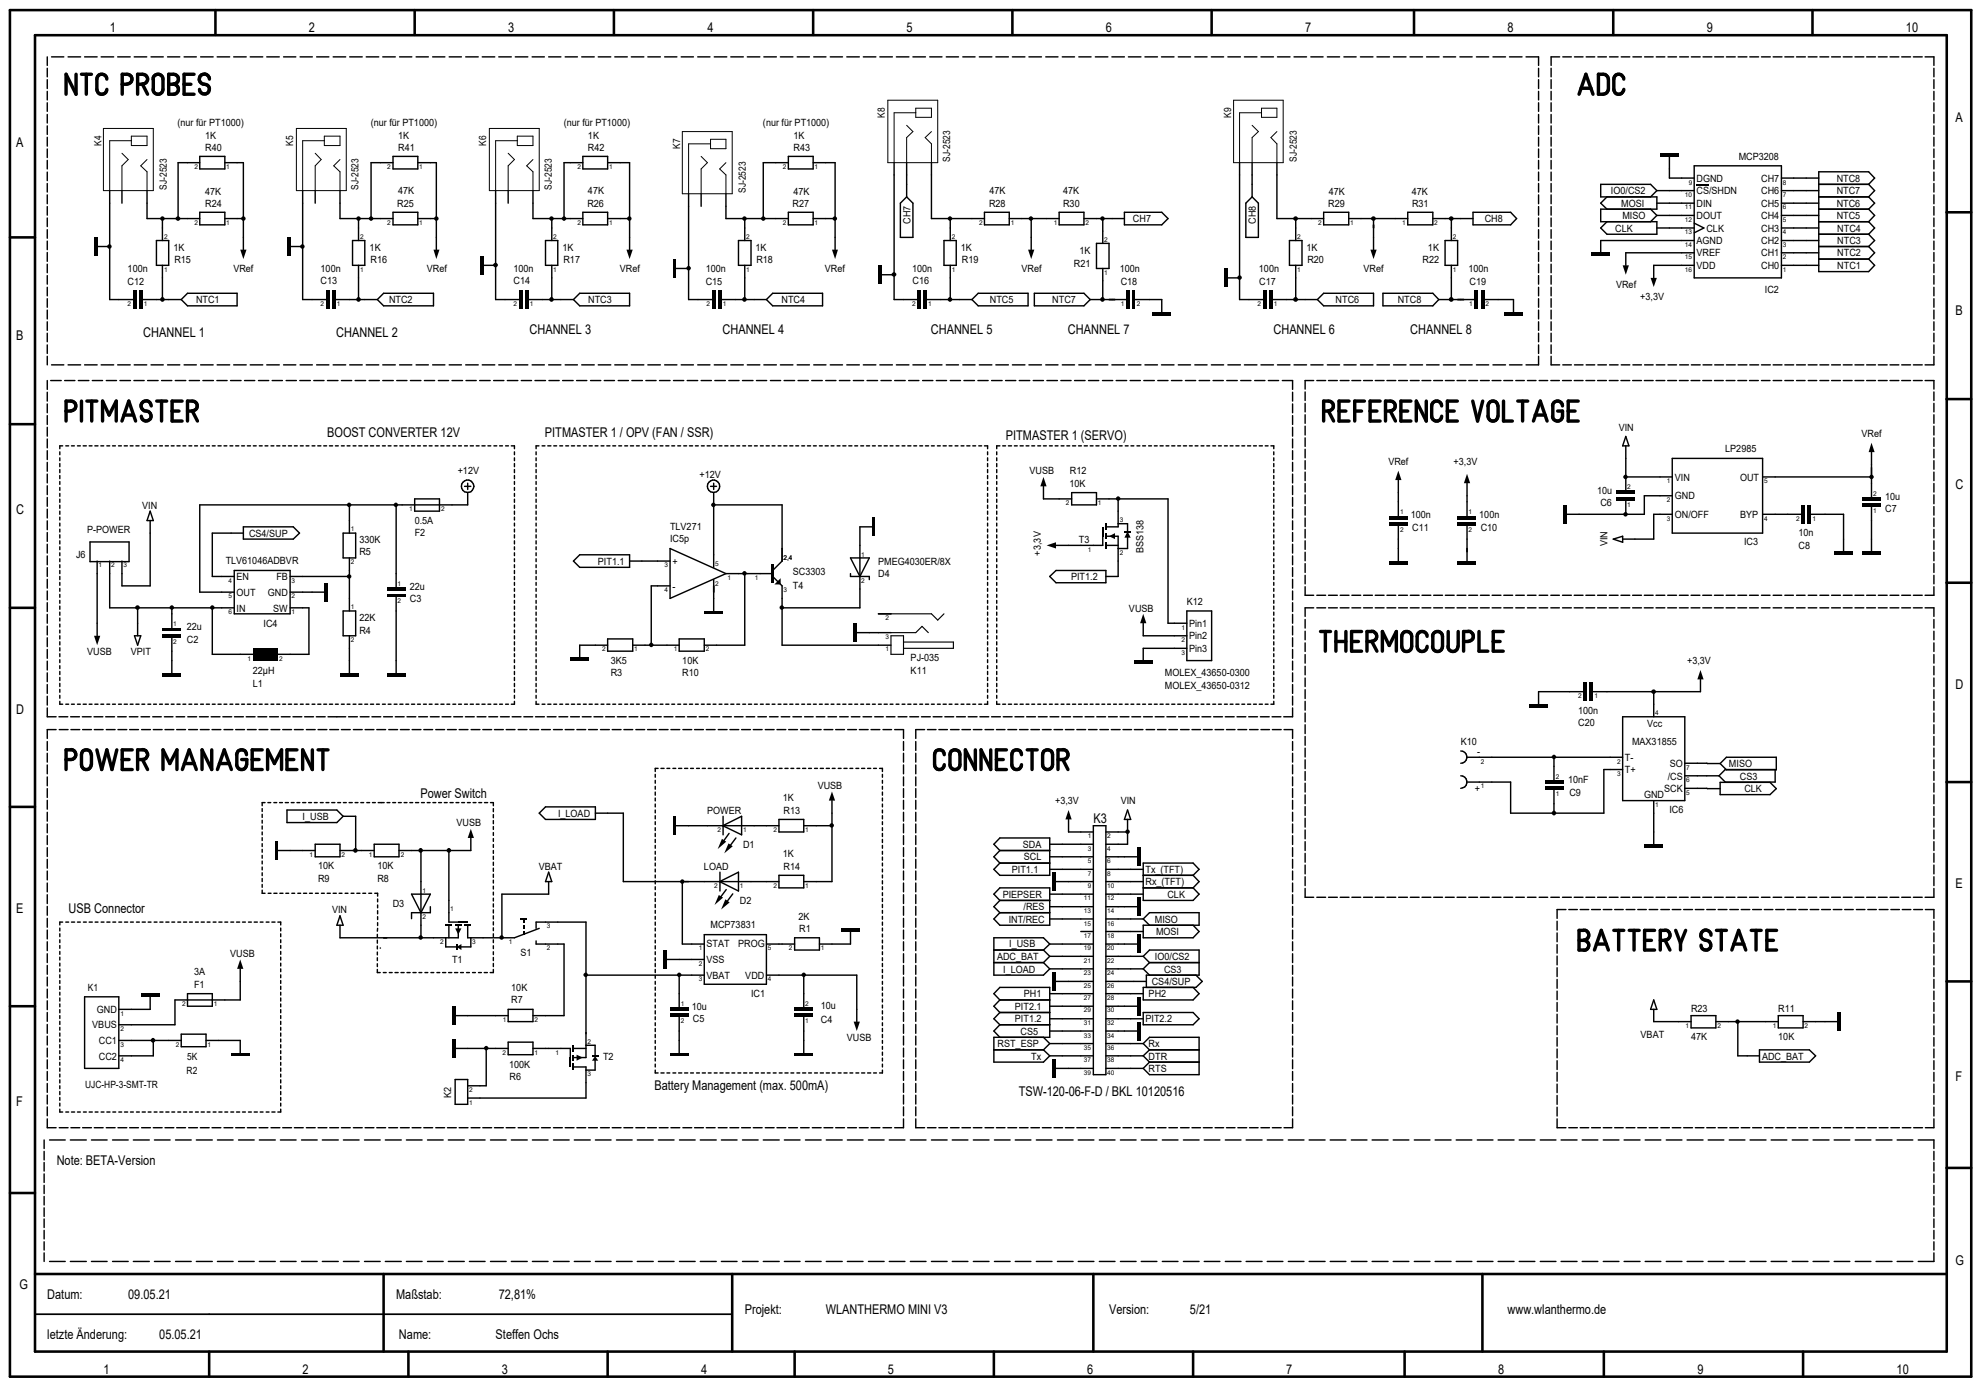
[picture p93: page 1]

UJC-HP-3-SMT-TR

Datum: 09.05.21 | Maßstab: 72,81% | Projekt: WLANTHERMO MINI V3 | Version: 5/21 | www.wlanthermo.de

letzte Änderung: 05.05.21 | Name: Steffen Ochs
