WLANThermo/WLANThermo_Hardware/link v1/circuit/Schaltplan WT Link V1 092020.pdf

## 128x64 OLED

A

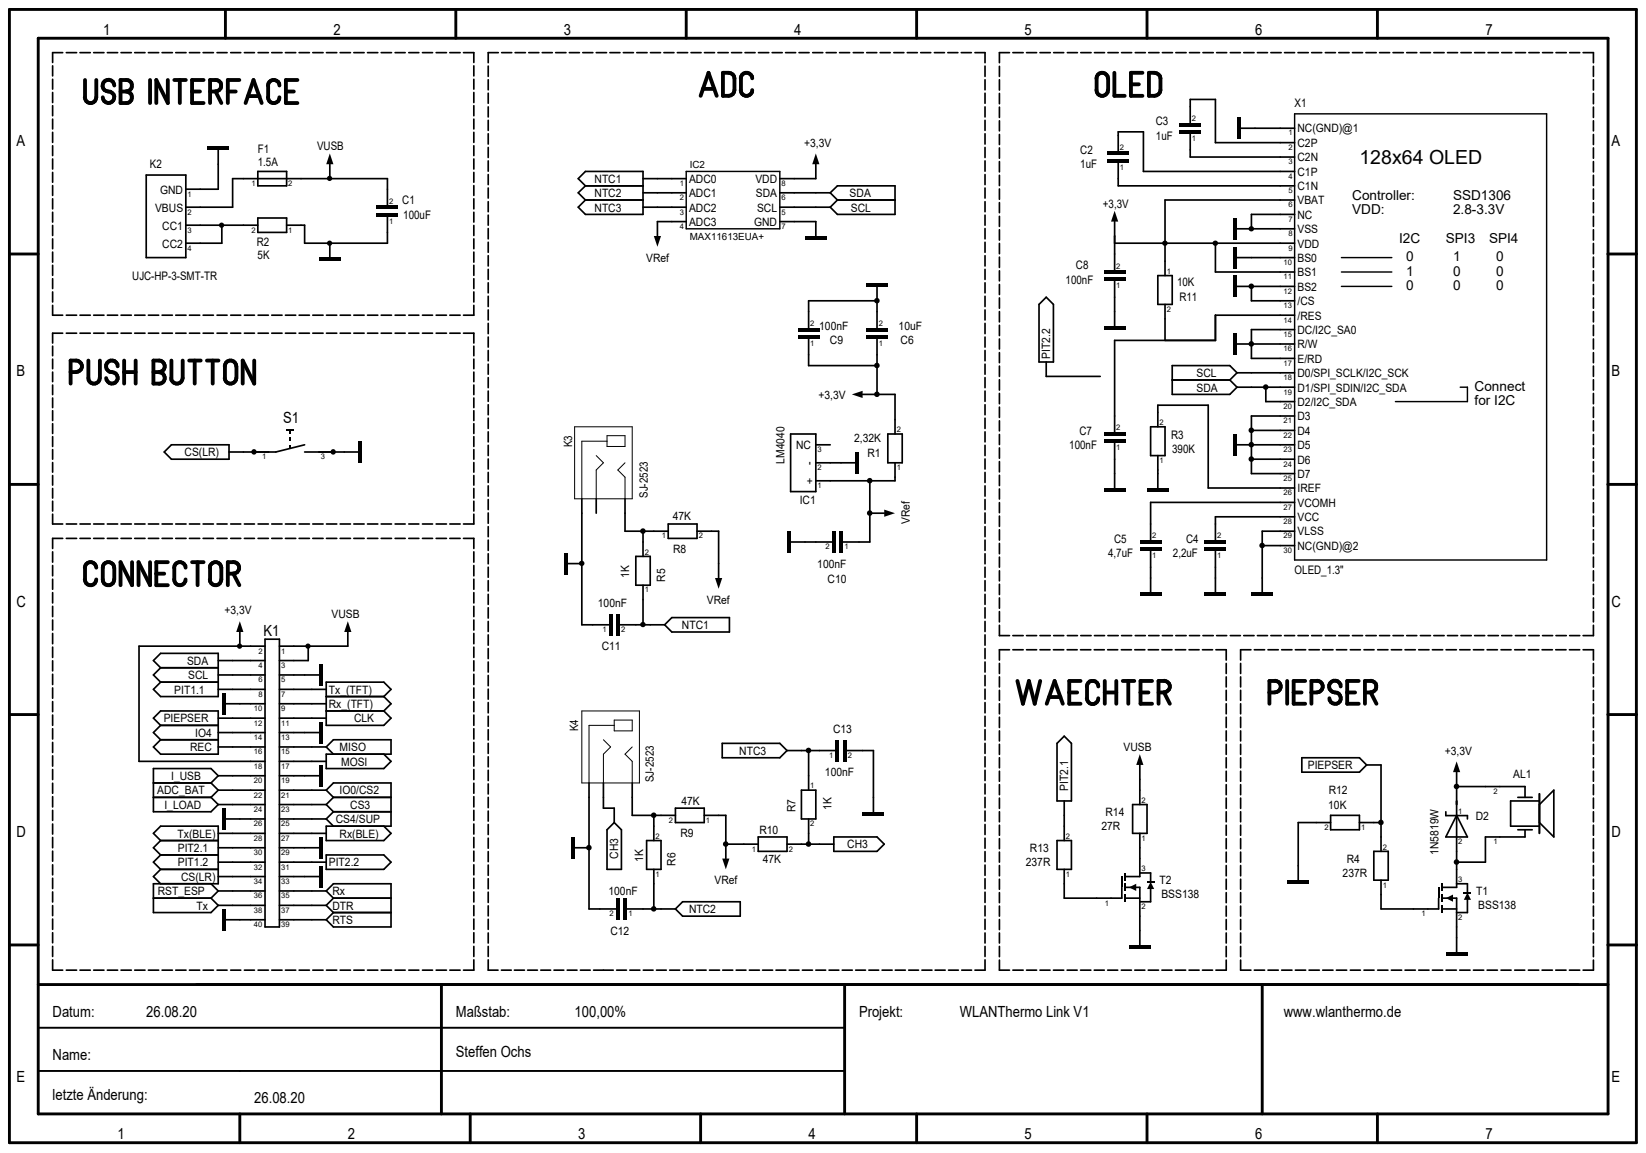
[picture p94: page 1]

UJC-HP-3-SMT-TR

ADC_BAT | IO0/CS2
I_LOAD | CS3

RST_ESP | Rx

Tx | DTR

Datum: 26.08.20 | Maßstab: 100,00% | Projekt: WLANThermo Link V1 | www.wlanthermo.de

Name: | Steffen Ochs

letzte Änderung: 26.08.20
