WLANThermo/WLANThermo_Hardware/mini v1/circuit/mini_schaltplan.pdf

## VCC_3,3V

A

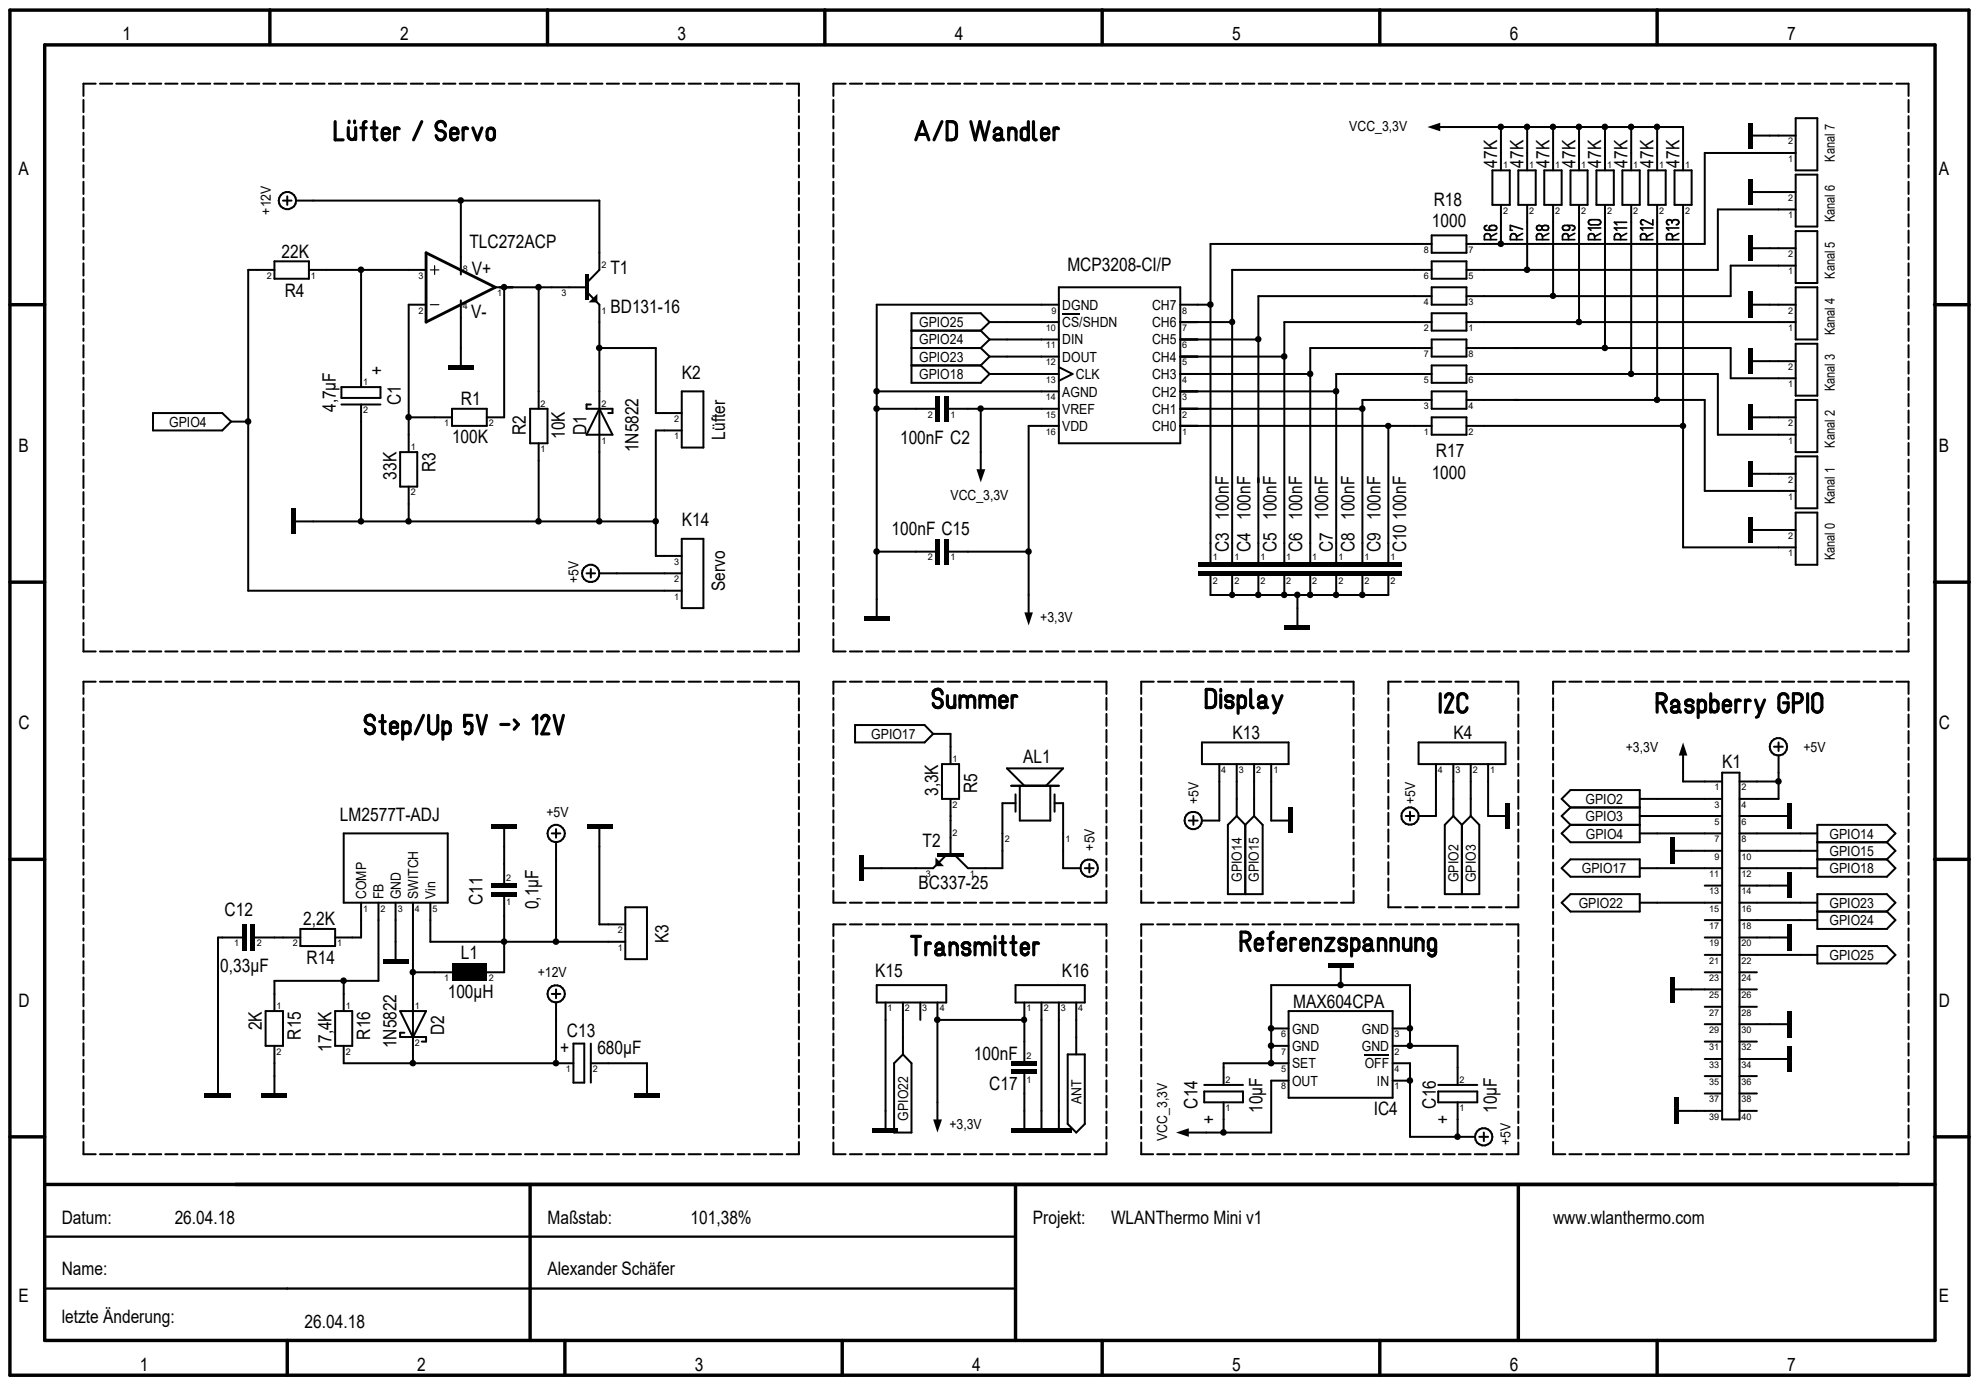
[picture p95: page 1]

Kanal 7 Kanal 6 Kanal 5 Kanal 4 Kanal 3 Kanal 2 Kanal 1 Kanal 0

Datum: 26.04.18 | Maßstab: 101,38% | Projekt: WLANThermo Mini v1 | www.wlanthermo.com

Name: | Alexander Schäfer

letzte Änderung: 26.04.18
