WLANThermo/WLANThermo_Hardware/mini v2/target/Add-On v1.1/Add-on v1.1 Schematic.pdf

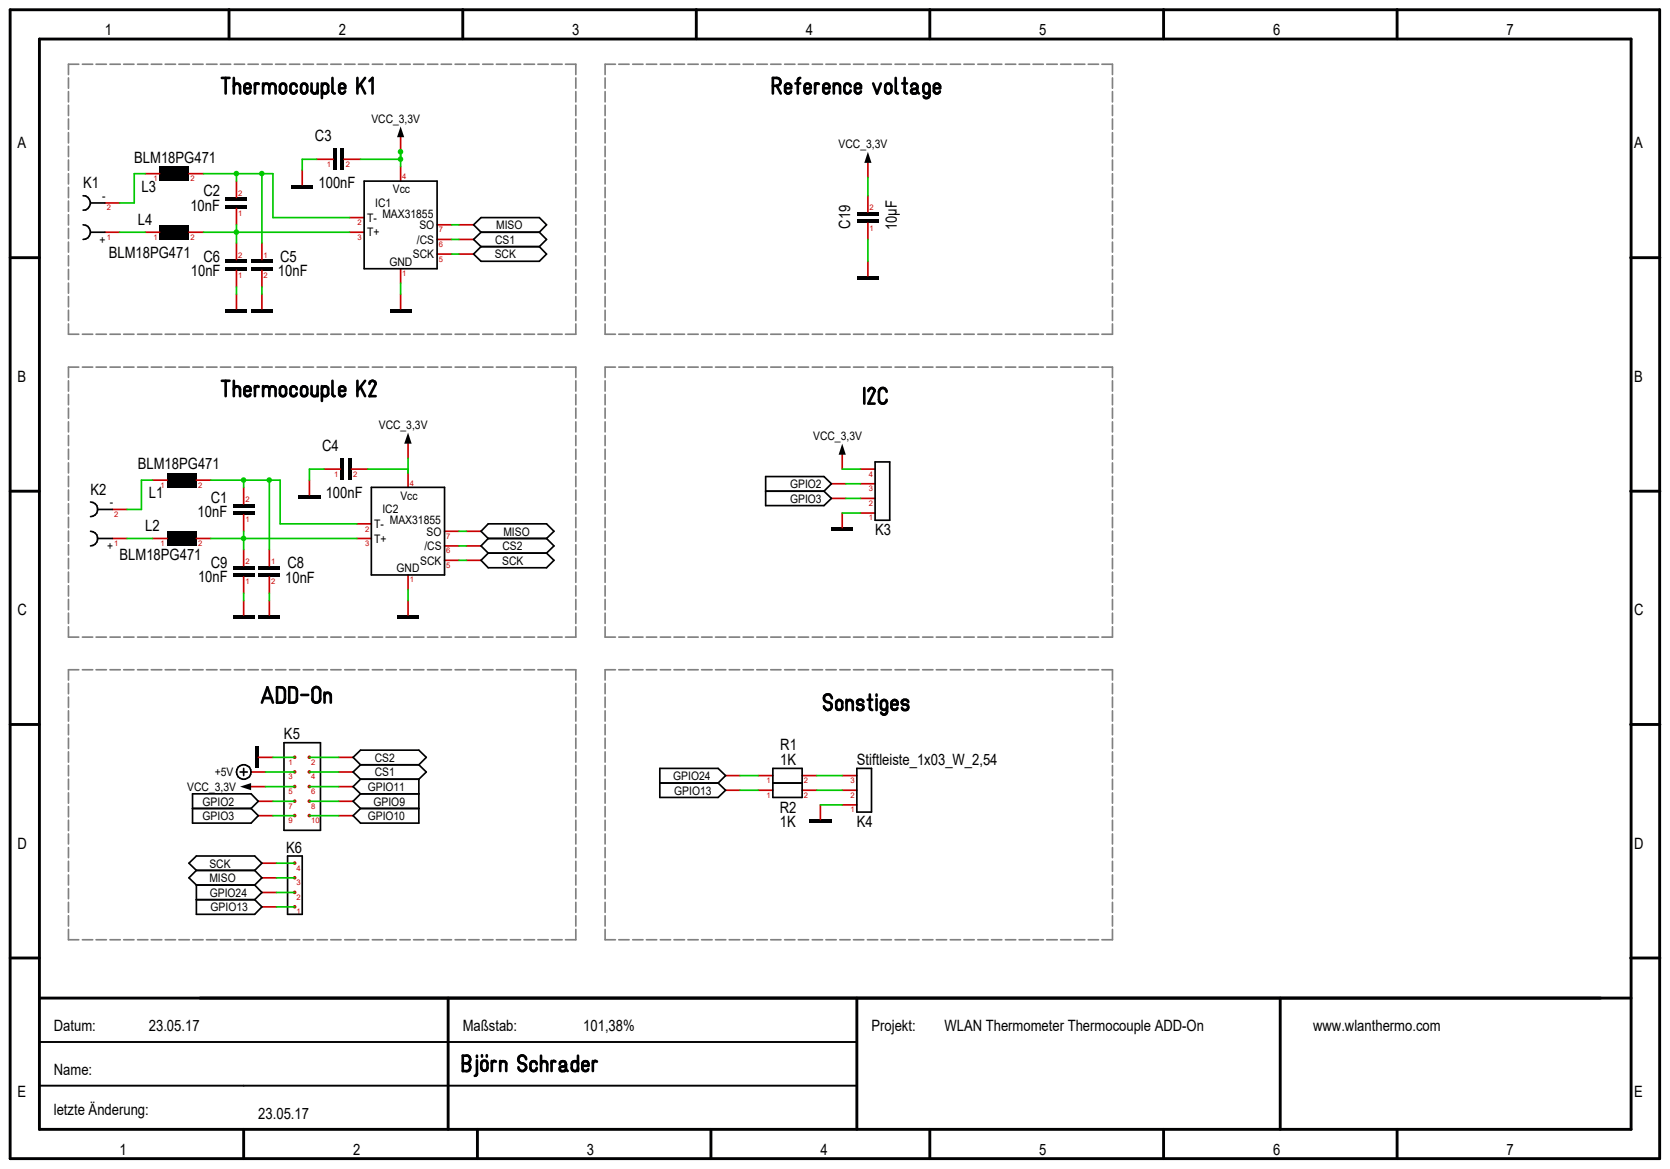
[picture p96: page 1]

Datum: 23.05.17 | Maßstab: 101,38% | Projekt: WLAN Thermometer Thermocouple ADD-On | www.wlanthermo.com

Name:

letzte Änderung: 23.05.17
