WLANThermo/WLANThermo_Hardware/mini v1/circuit/mini_bestueckung.pdf

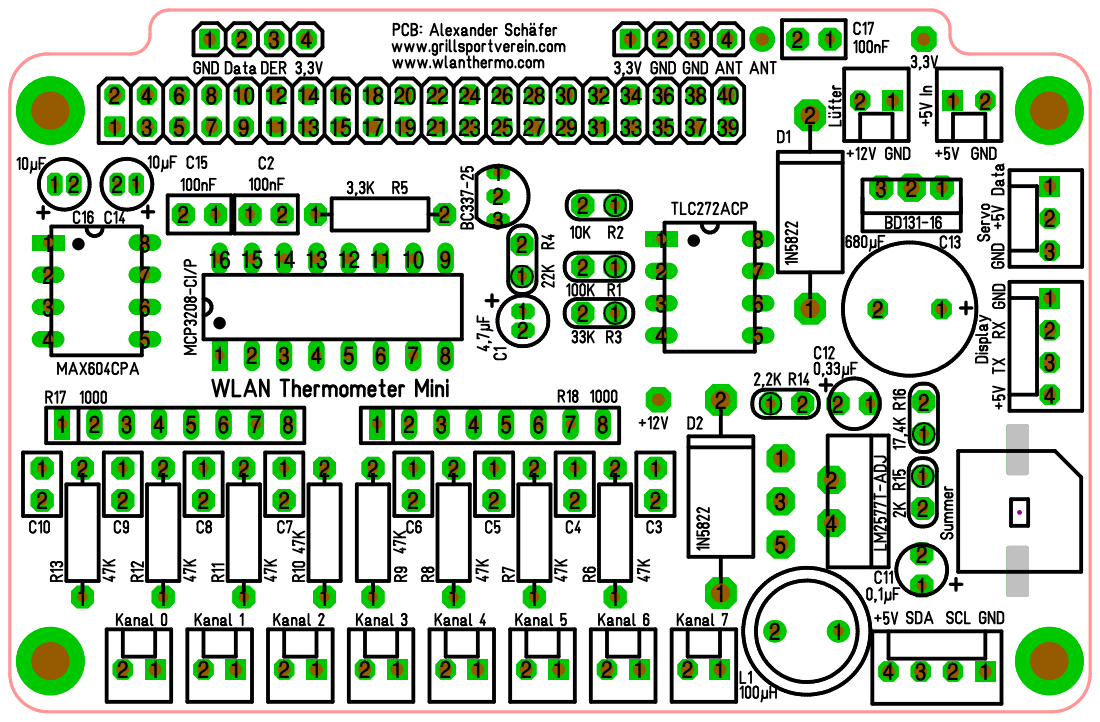
[picture p97: page 1]
