WLANThermo/WLANThermo_Hardware/mini v2/target/Add-On v1.1/Add-on v1.1 Board.pdf

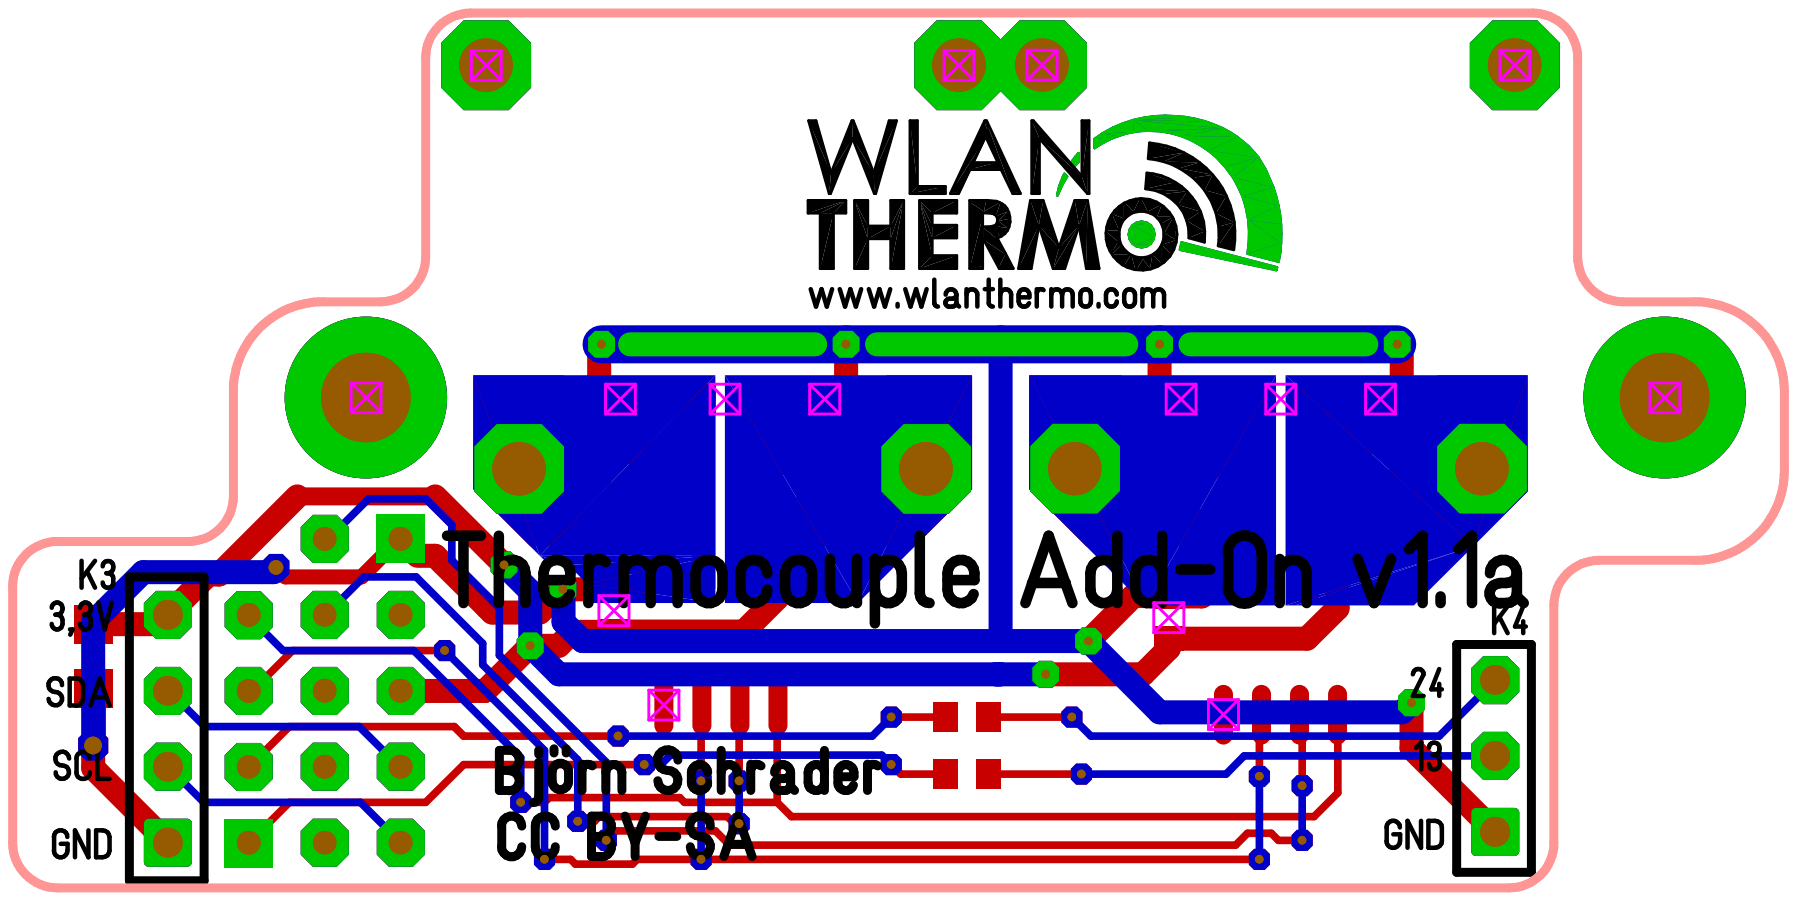
[picture p98: page 1]
