WLANThermo/WLANThermo_Hardware/mini v2/target/Mini v2/Mini v2 Board.pdf

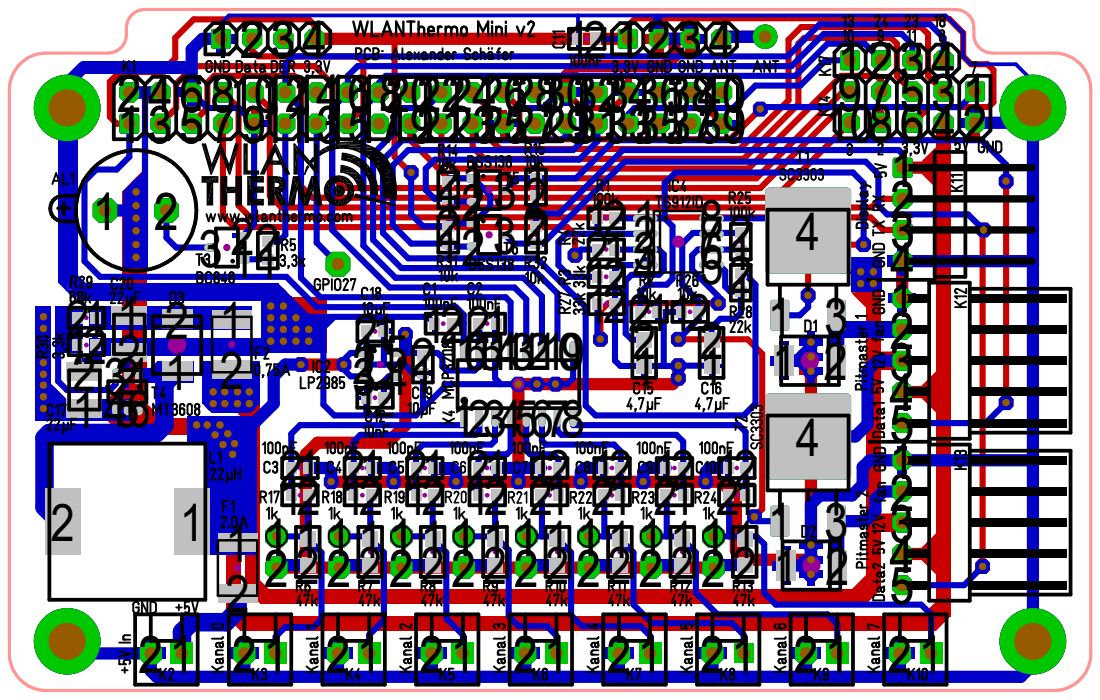
[picture p99: page 1]
