WLANThermo/WLANThermo_Hardware/(commit log)

2016-02-09 Initial upload
    Upload der Gerber Dateiene und ein bisschen Doku.
    [mini_bauteilliste.xlsx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]
2016-02-15 Upload der Gehäusevarianten
    Upload der Gehäusevarianten aus
    http://www.grillsportverein.de/forum/threads/wlan-thermometer-mini-gehaeuse-varianten.253520
    [Deckel_Anschluss_links_mittig_rechts.stp, Deckel_Anschluss_links_mittig_rechts_J3DI_mod_v1_2.STL, Deckel_Anschluss_links_rechts.stp, Deckel_Anschluss_mittig.stp, Deckel_Anschluss_mittig_J3DI_mod.STL, Deckel_oben_Anschluss_li_re.stl, Deckel_oben_Anschluss_li_re_mi.stl, Deckel_oben_Anschluss_mittig.stl]
2016-02-24 Upload fehlender Ressourcen
    [Klinkensteckerbuchse 2,5.stp, USB Micro Breakout.stp, USB_Type_A_Female_Breakout.stp]
2016-02-24 Ordnerstruktur angepasst
    [Display 2,8.stp, Halter_Innenleben.stp]
2016-02-27 KLB 1 mit Mutter
    [Klinkensteckerbuchse 2,5.stp]
2016-08-31 Deckel mit 4 Pitmaster Anschlüssen
    [Deckel_4_Anschluesse.stl]
2017-03-11 Mini v2
    [Antenne Funk.step, Buchsenleiste.stp, HEBL 21 Mutter.stp, HEBL 21.stp, KLB 1 Mutter.stp, KLB 1.stp, LCD mit schwarzem Bildschirm v1.stp, LUM 1502-02 Mutter.stp]
2017-03-15 Bug fix
    [WLTMV2-case_ top.STEP, WLTMV2-case_bottom_J3DI_v1_0r.STEP, WLTMV2-case_top_J3DI_v1_0_1r.STEP]
2017-05-23 Add-On v1.1
    Add-On with better signal filtering
2017-06-13 Add-On v1.1a
    Felder zum anlöten der Abschirmung hinzugefügt
2018-04-26 Add: Gehäuseinformationen
    [Deckel_4_Anschluesse.stl, Deckel_Anschluss_links_mittig_rechts.stp, Deckel_Anschluss_links_mittig_rechts_J3DI_mod_v1_2.STL, Deckel_Anschluss_links_rechts.stp, Deckel_Anschluss_mittig.stp, Deckel_Anschluss_mittig_J3DI_mod.STL, Deckel_oben.CATPart, Deckel_oben_Anschluss_li_re.stl]
2018-04-26 Add: Readme Gerber
2018-04-26 Update: Gerber Readme
    [MiniFunk.GBL, MiniFunk.GBO, MiniFunk.GBS, MiniFunk.GTL, MiniFunk.GTO, MiniFunk.GTS]
2018-04-26 Add: circuit ordner
2018-04-26 Add: BOM
2018-04-27 Update: BOM mini v1
2018-04-27 Update BOM Mini v1
2018-10-03 Add: Pitmaster-Berechnungstabelle
    [Pitmaster_Berechnungstabelle.xlsx]
2020-07-01 Add esp32 kit
2020-08-26 Add bom link V1
2020-08-26 Update bom link
2020-08-26 Add circuit link
2021-01-29 Update BOM Mini V3
2021-04-20 Add Mini V3 Gerber Files
